lusher00/pov-display/hw/povd-hub/calc/buck_loop.png

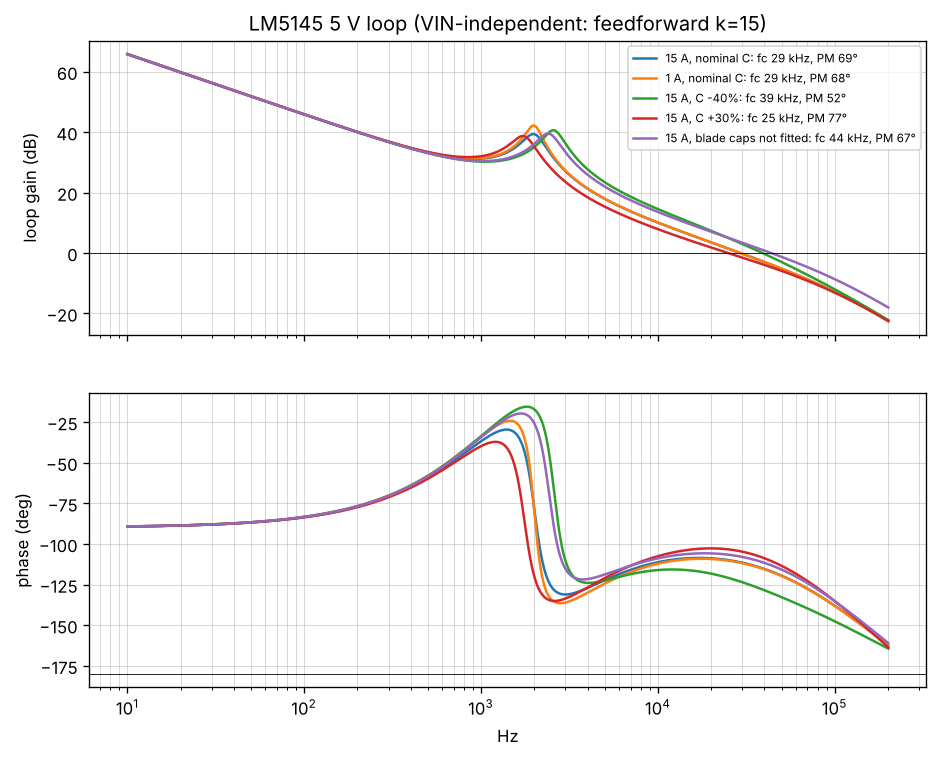
hw/povd-hub/calc/buck_loop.png
