lusher00/pov-display/tools/sim/demo/assets/spinner1.gif

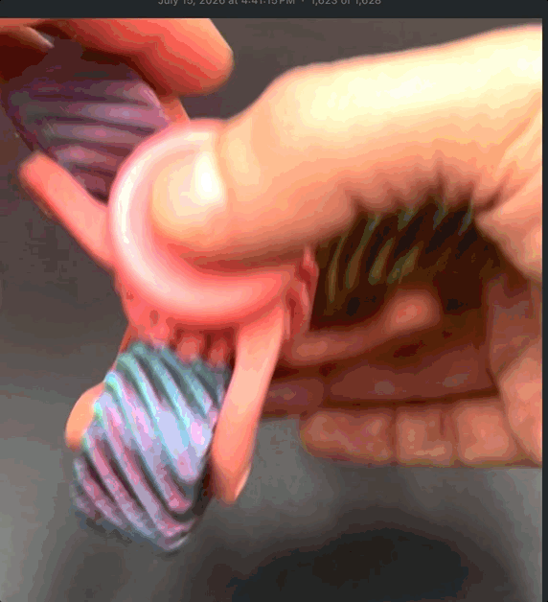
tools/sim/demo/assets/spinner1.gif
