lusher00/pov-display/tools/sim/demo/assets/spinner2.gif

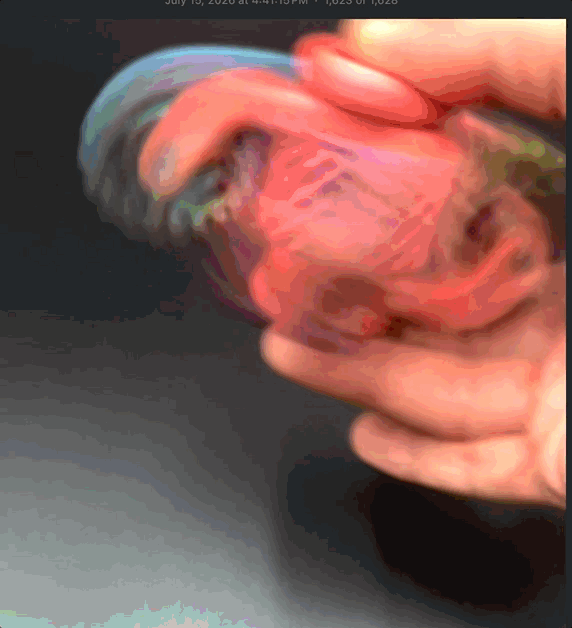
tools/sim/demo/assets/spinner2.gif
