lusher00/pov-display/tools/sim/demo/assets/spinner3.gif

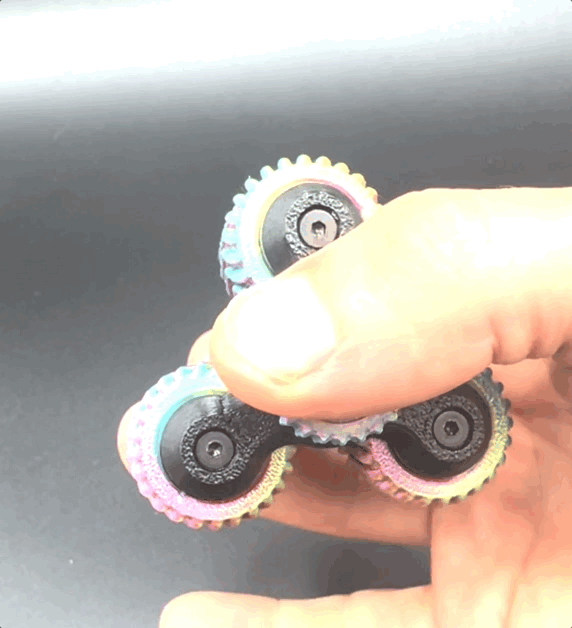
tools/sim/demo/assets/spinner3.gif
