lusher00/pov-display/hw/povd-hub/fab/povd-hub_BOM_JLC.csv

Comment | Designator | Footprint | LCSC Part #
100nF 25V X7R 0603 | C1,C7,C17 | 0603 | C53084467
100nF 50V X7R 0603 | C2,C3,C34,C35,C36,C51,C53,C55 | 0603 | C53084467
10uF 10V X5R 0805 | C9,C33,C39,C40,C41,C42,C45,C46,C47,C48 | 0805 | C15850
1uF 100V X7R 0805 | C10 | 0805 | C105952
47nF 50V X7R 0603 | C15 | 0603 | C1622
2.2uF 16V X7R 0805 | C16 | 0805 | C377773
330pF 100V X7R 0603 (Yageo CC0603KRX7R0BB331) | C19 | 0603 | C576850
6.8nF 50V X7R 0603 | C20 | 0603 | C1631
12nF 50V X7R 0603 | C21 | 0603 | C107074
68pF 50V C0G 0603 | C22 | 0603 | C28262
1uF 16V X7R 0603 | C49 | 0603 | C15849
1nF 50V X7R 0603 | C50,C52 | 0603 | C1588
B5819W | D2 | SOD-123 | C8598
Green LED 0603 | D3 | 0603 | C12065
PESD5V0S1BA | D4,D5,D6 | SOD-323 | C19224
GH 4P | J4,J6 | JST GH BM04B-GHS-TBT | C161692
GH 5P OPT | J5 | JST GH BM05B-GHS-TBT | C189891
BSC040N08NS5 | Q1,Q3 | TDSON-8 (PG-TDSON-8) | C534333
CSD19533Q5A | Q2 | SON 5x6 (TDSON-8 land) | C110197
AO3400A | Q4 | SOT-23 | C20917
1k 1% 0603 | R2,R37,R39,R43 | 0603 | C21190
95.3k 1% 0603 | R5 | 0603 | C23267
16.9k 1% 0603 | R6 | 0603 | C227614
10k 1% 0603 | R7,R13,R17 | 0603 | C25804
100k 1% 0603 | R8,R42 | 0603 | C25803
24.9k 1% 0603 | R9 | 0603 | C25962
2.2R 1% 0603 | R10 | 0603 | C22939
360R 1% 0603 | R11 | 0603 | C25194
2.2R 0.5W 0805 anti-surge (Panasonic ERJ-P06J2R2V) | R12 | 0805 | C543414
1.91k 1% 0603 | R14 | 0603 | C22853
680R 1% 0603 | R15 | 0603 | C23228
11k 1% 0603 | R16 | 0603 | C25950
2.2k 1% 0603 | R18 | 0603 | C4190
33R 1% 0603 | R20,R21,R22,R23,R24,R25,R26,R27,R28,R29,R30,R31,R32,R33,R34,R35 | 0603 | C23140
4.7k 1% 0603 | R36,R38 | 0603 | C23162
47R 1% 1206 | R40 | 1206 | C17969
100R 1% 0603 | R41,R44 | 0603 | C22775
Keystone 5015 test point | TP7,TP8,TP10,TP11,TP12,TP13,TP14,TP15,TP16,TP17 | Keystone 5015 | C2906768
LM74700-Q1 | U1 | SOT-23-6 | C2941042
INA240A3D | U2 | SOIC-8 | C2060584
LMR51610XDBVR | U3 | SOT-23-6 | C20539658
LM5145QRGYRQ1 | U4 | VQFN-20 3.5x4.5 (RGY) | C3188678
74AHCT245PW | U6,U7 | TSSOP-20 | C173388
74LVC1G17 | U8,U9,U10 | SOT-23-5 | C7836
