lusher00/pov-display/hw/povd-hub/povd-hub-schematic.pdf

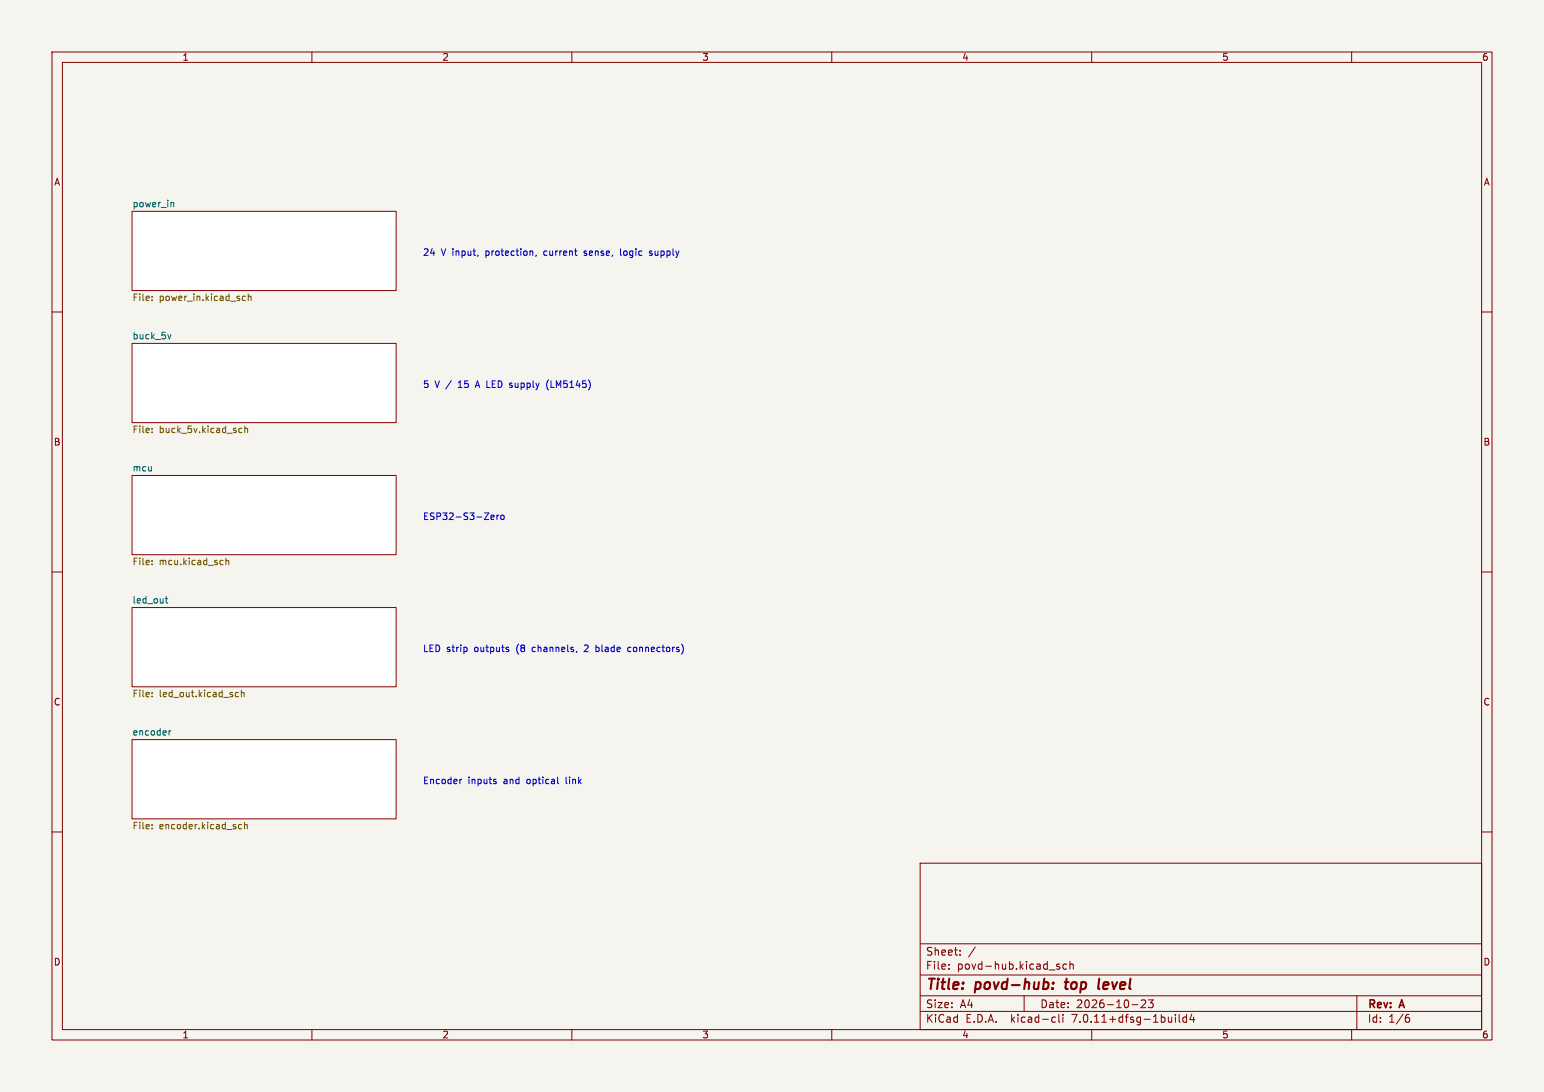
[picture p7: page 1]

buck_5v File: buck_5v.kicad_sch mcu File: mcu.kicad_sch

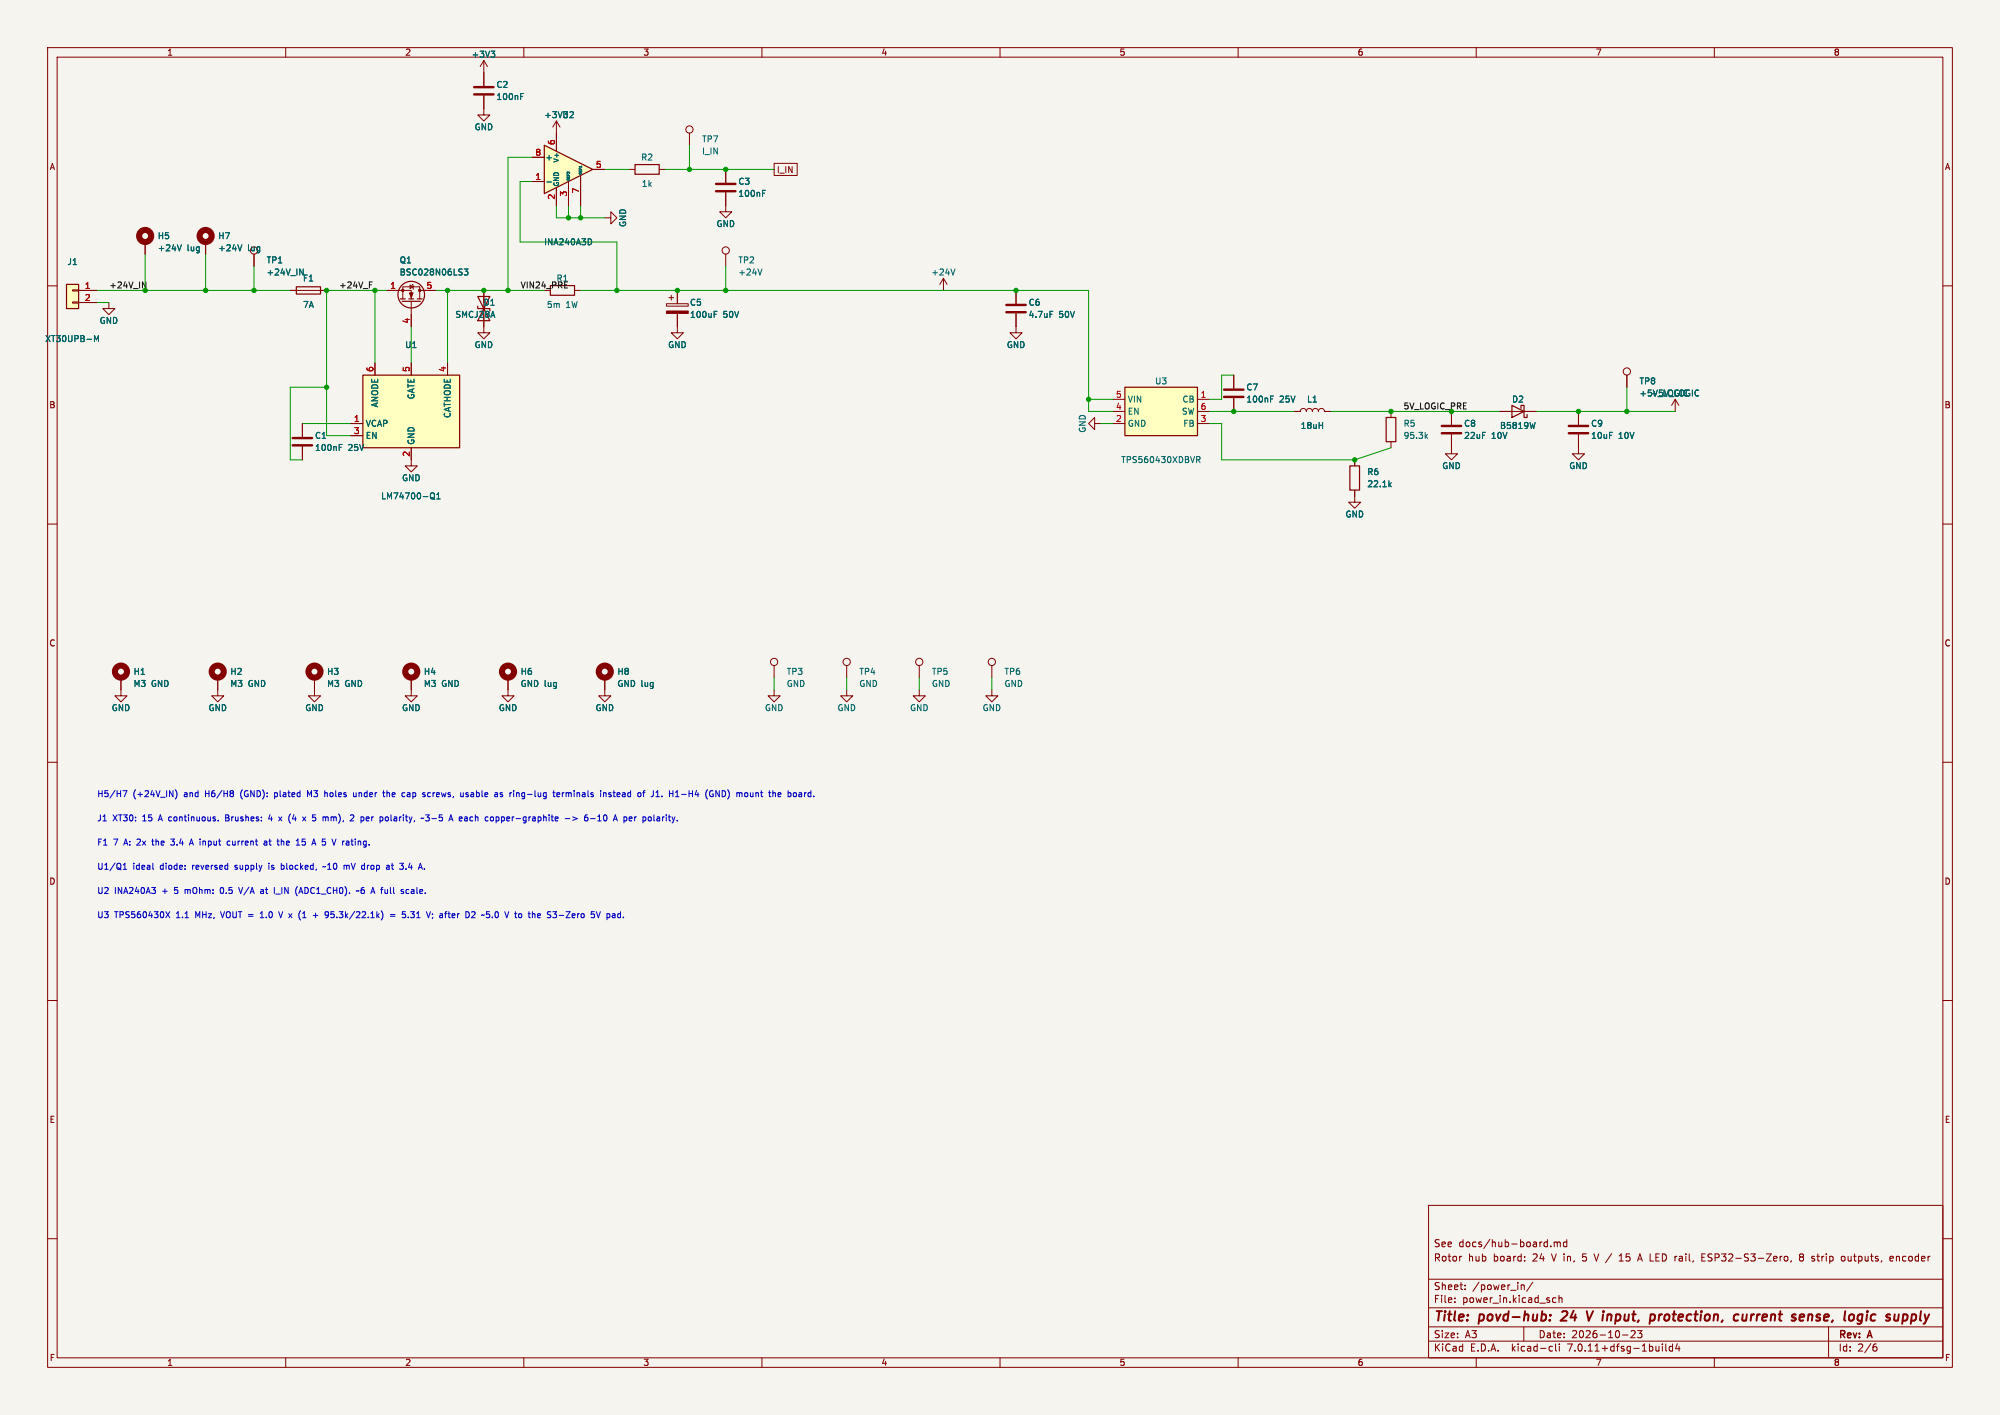
[picture p8: page 2]

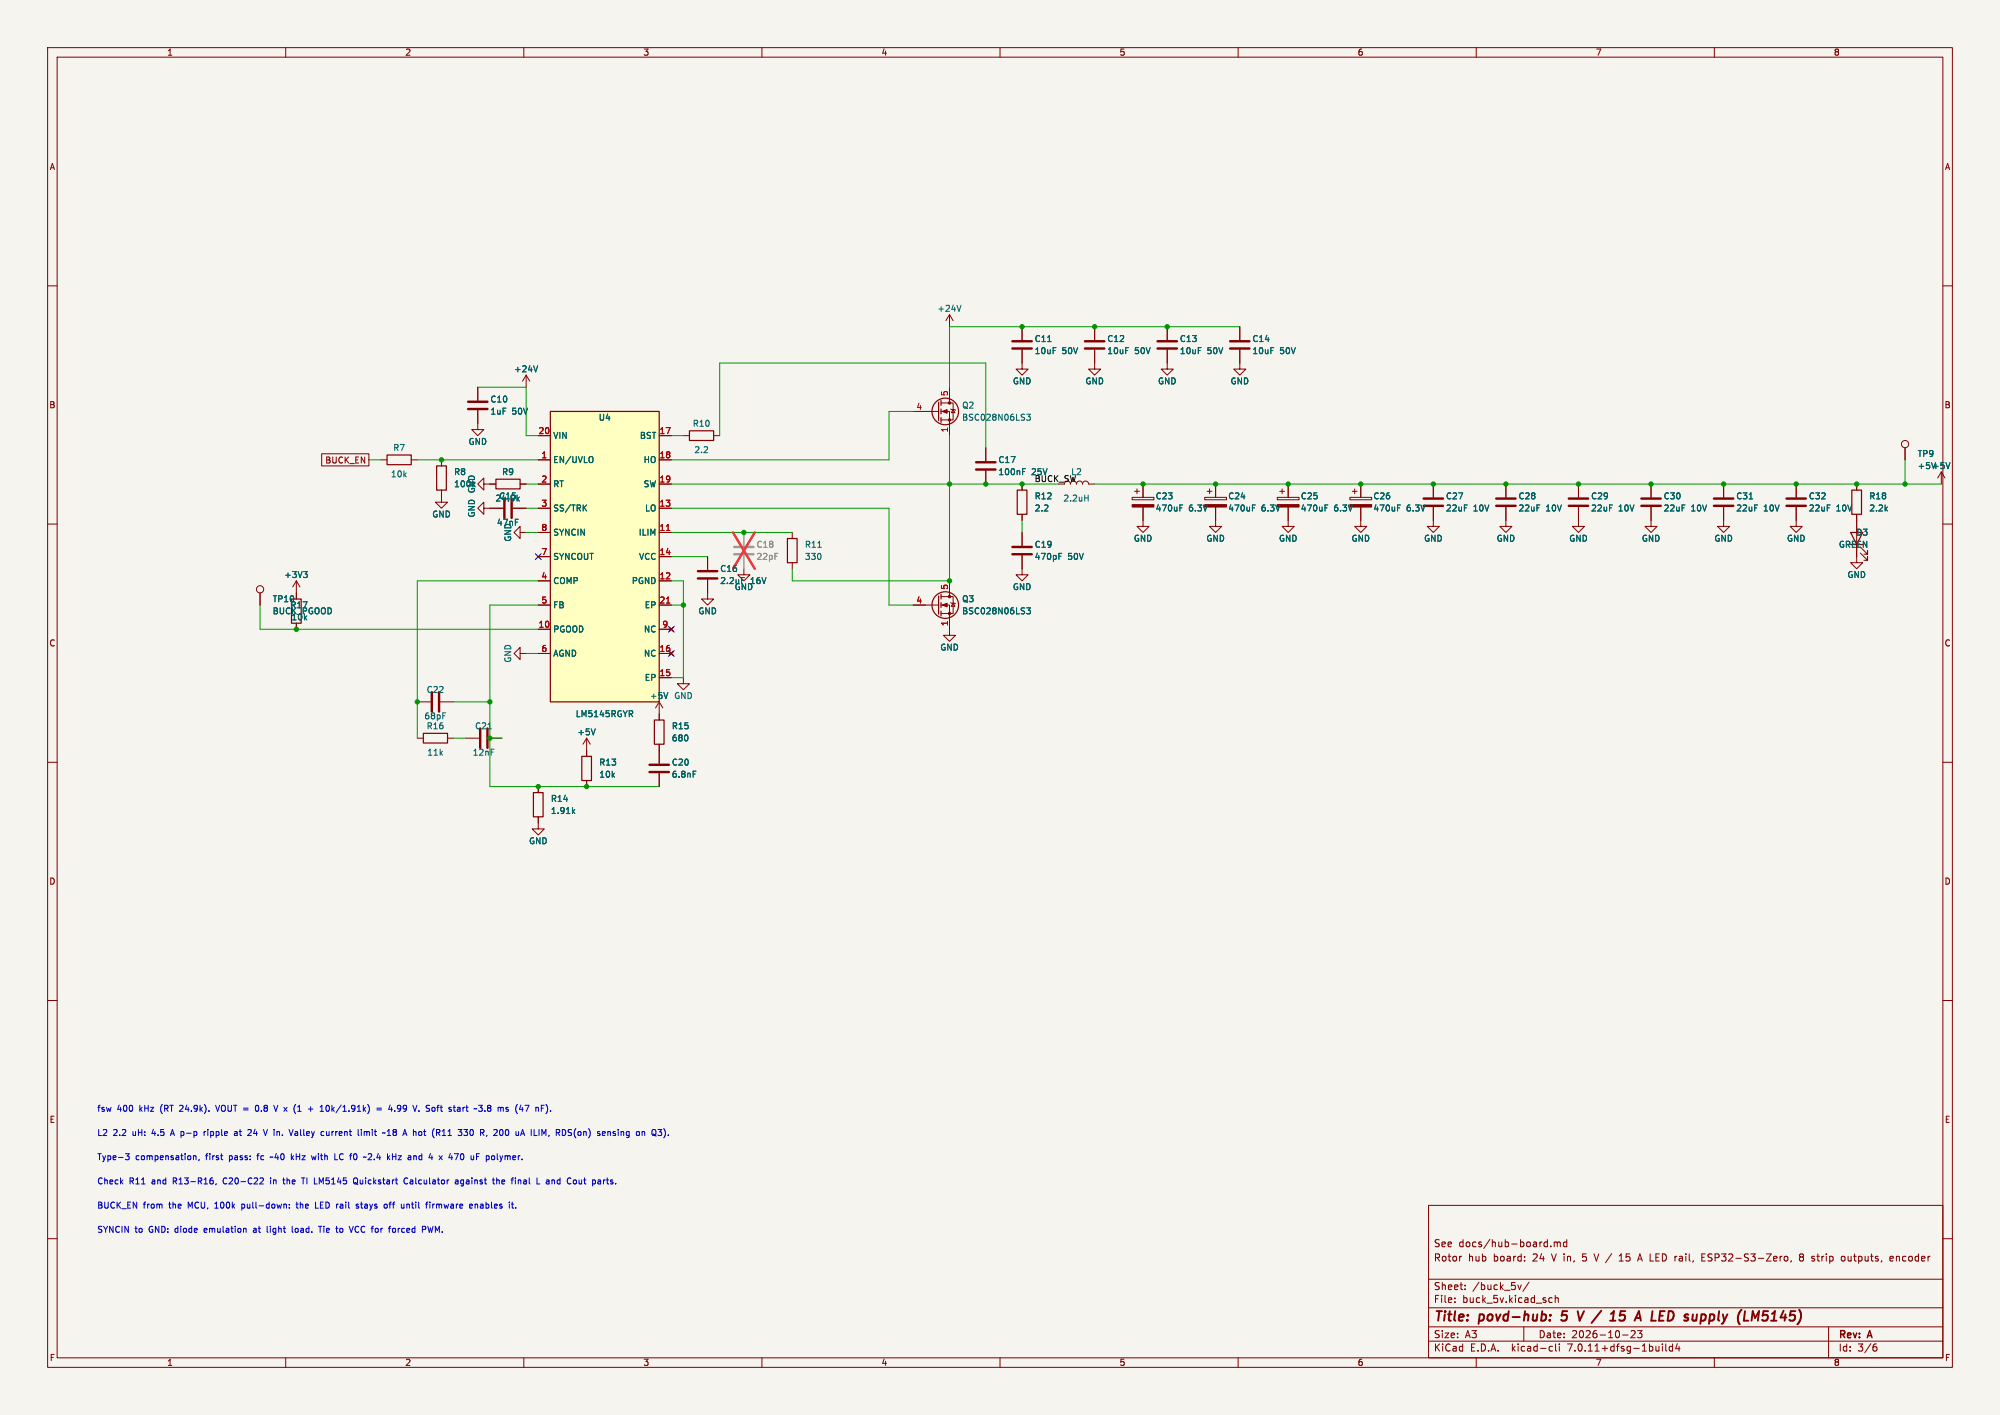
[picture p9: page 3]

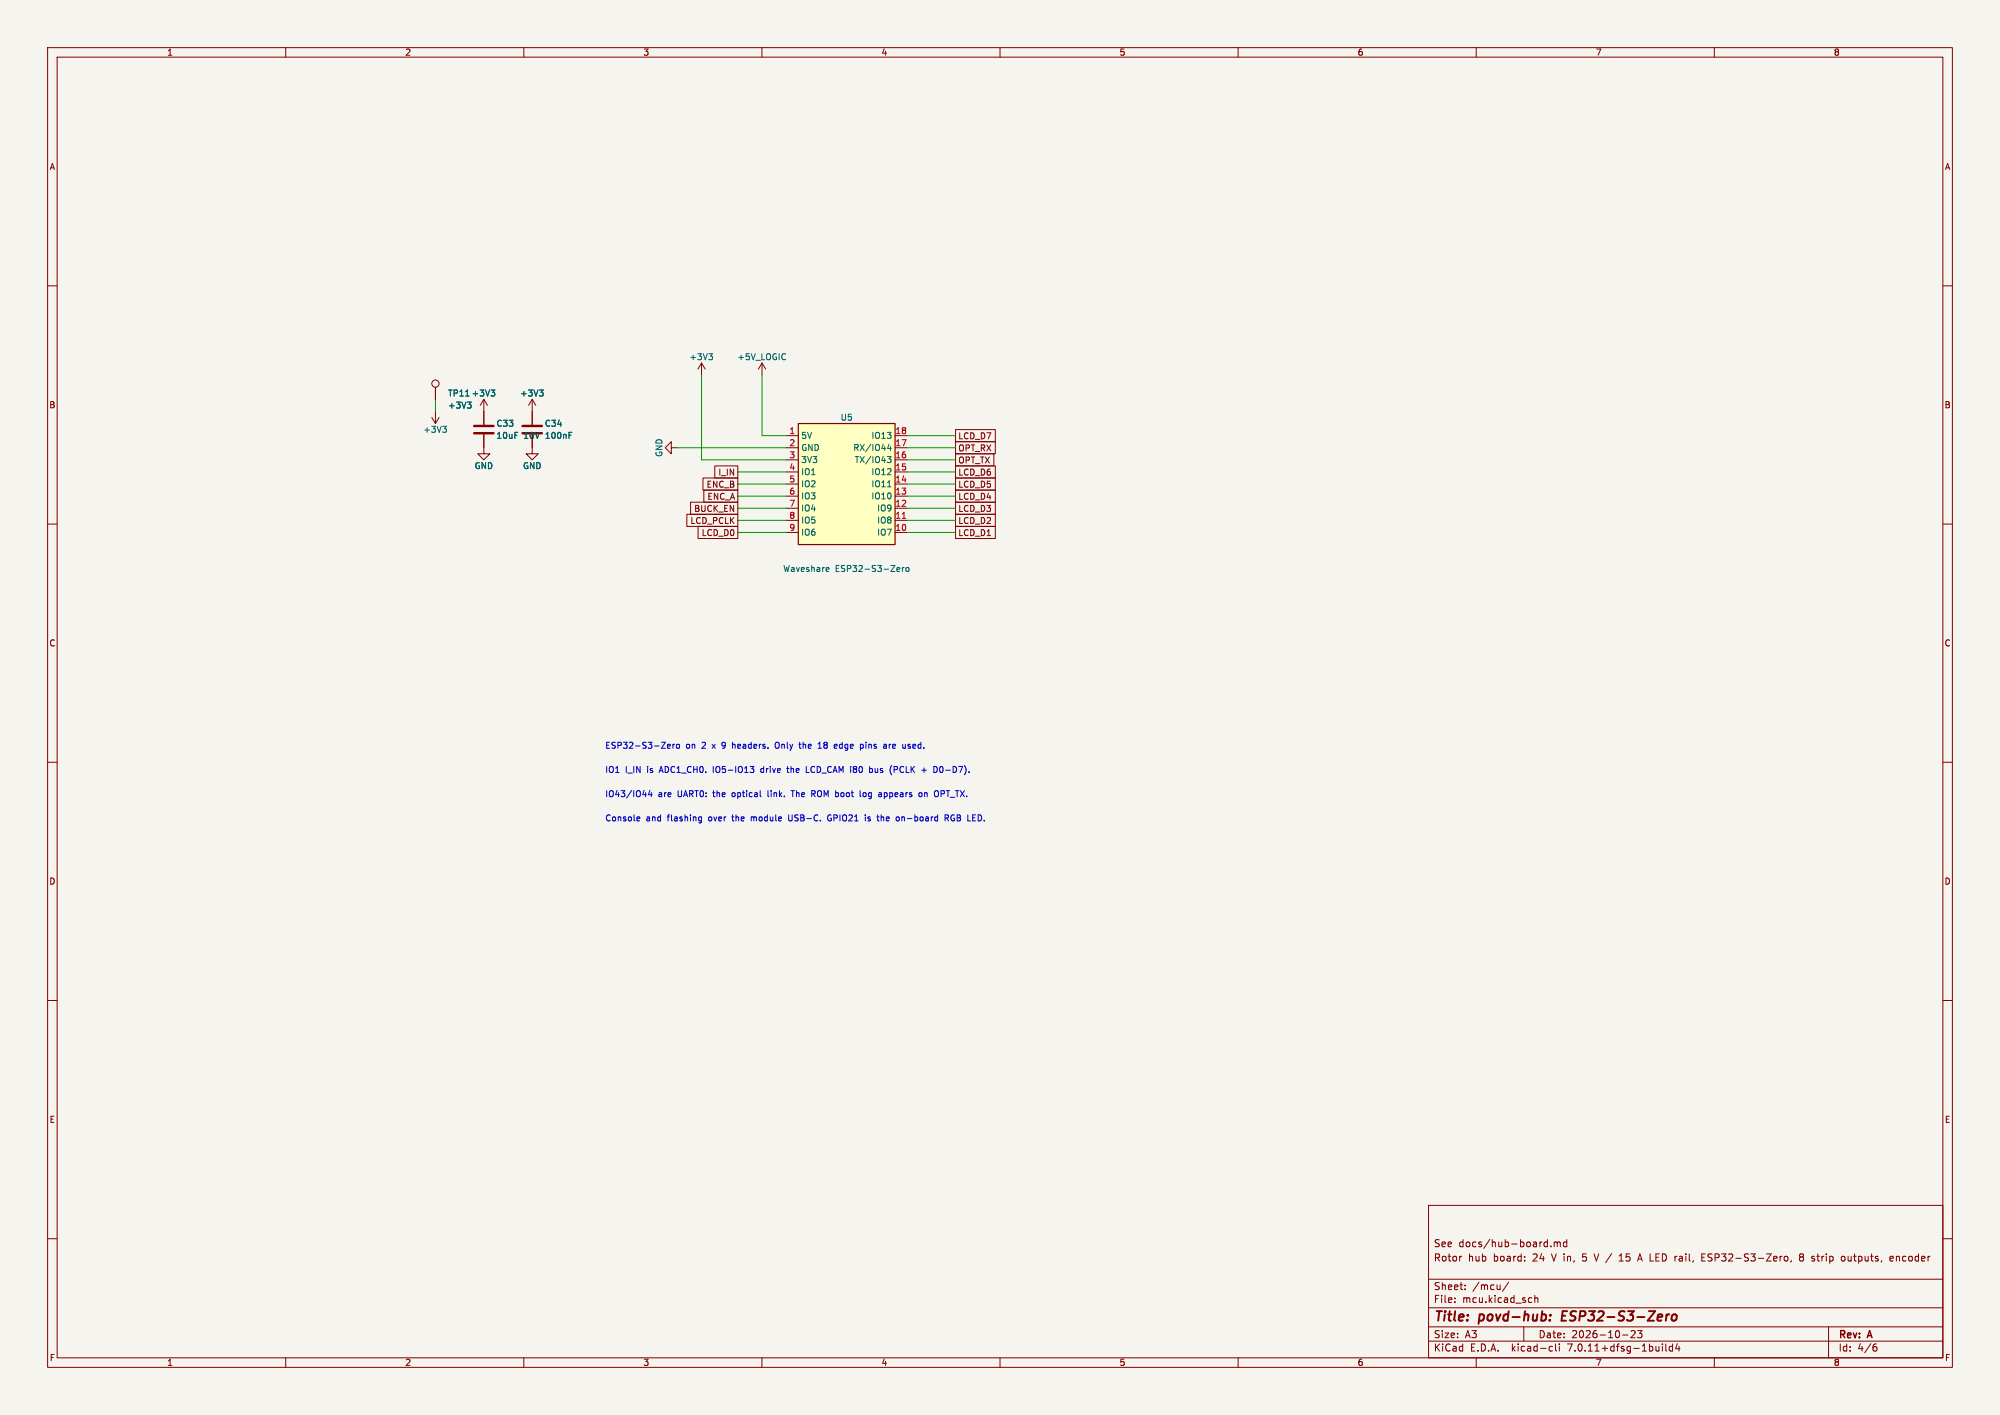
[picture p10: page 4]

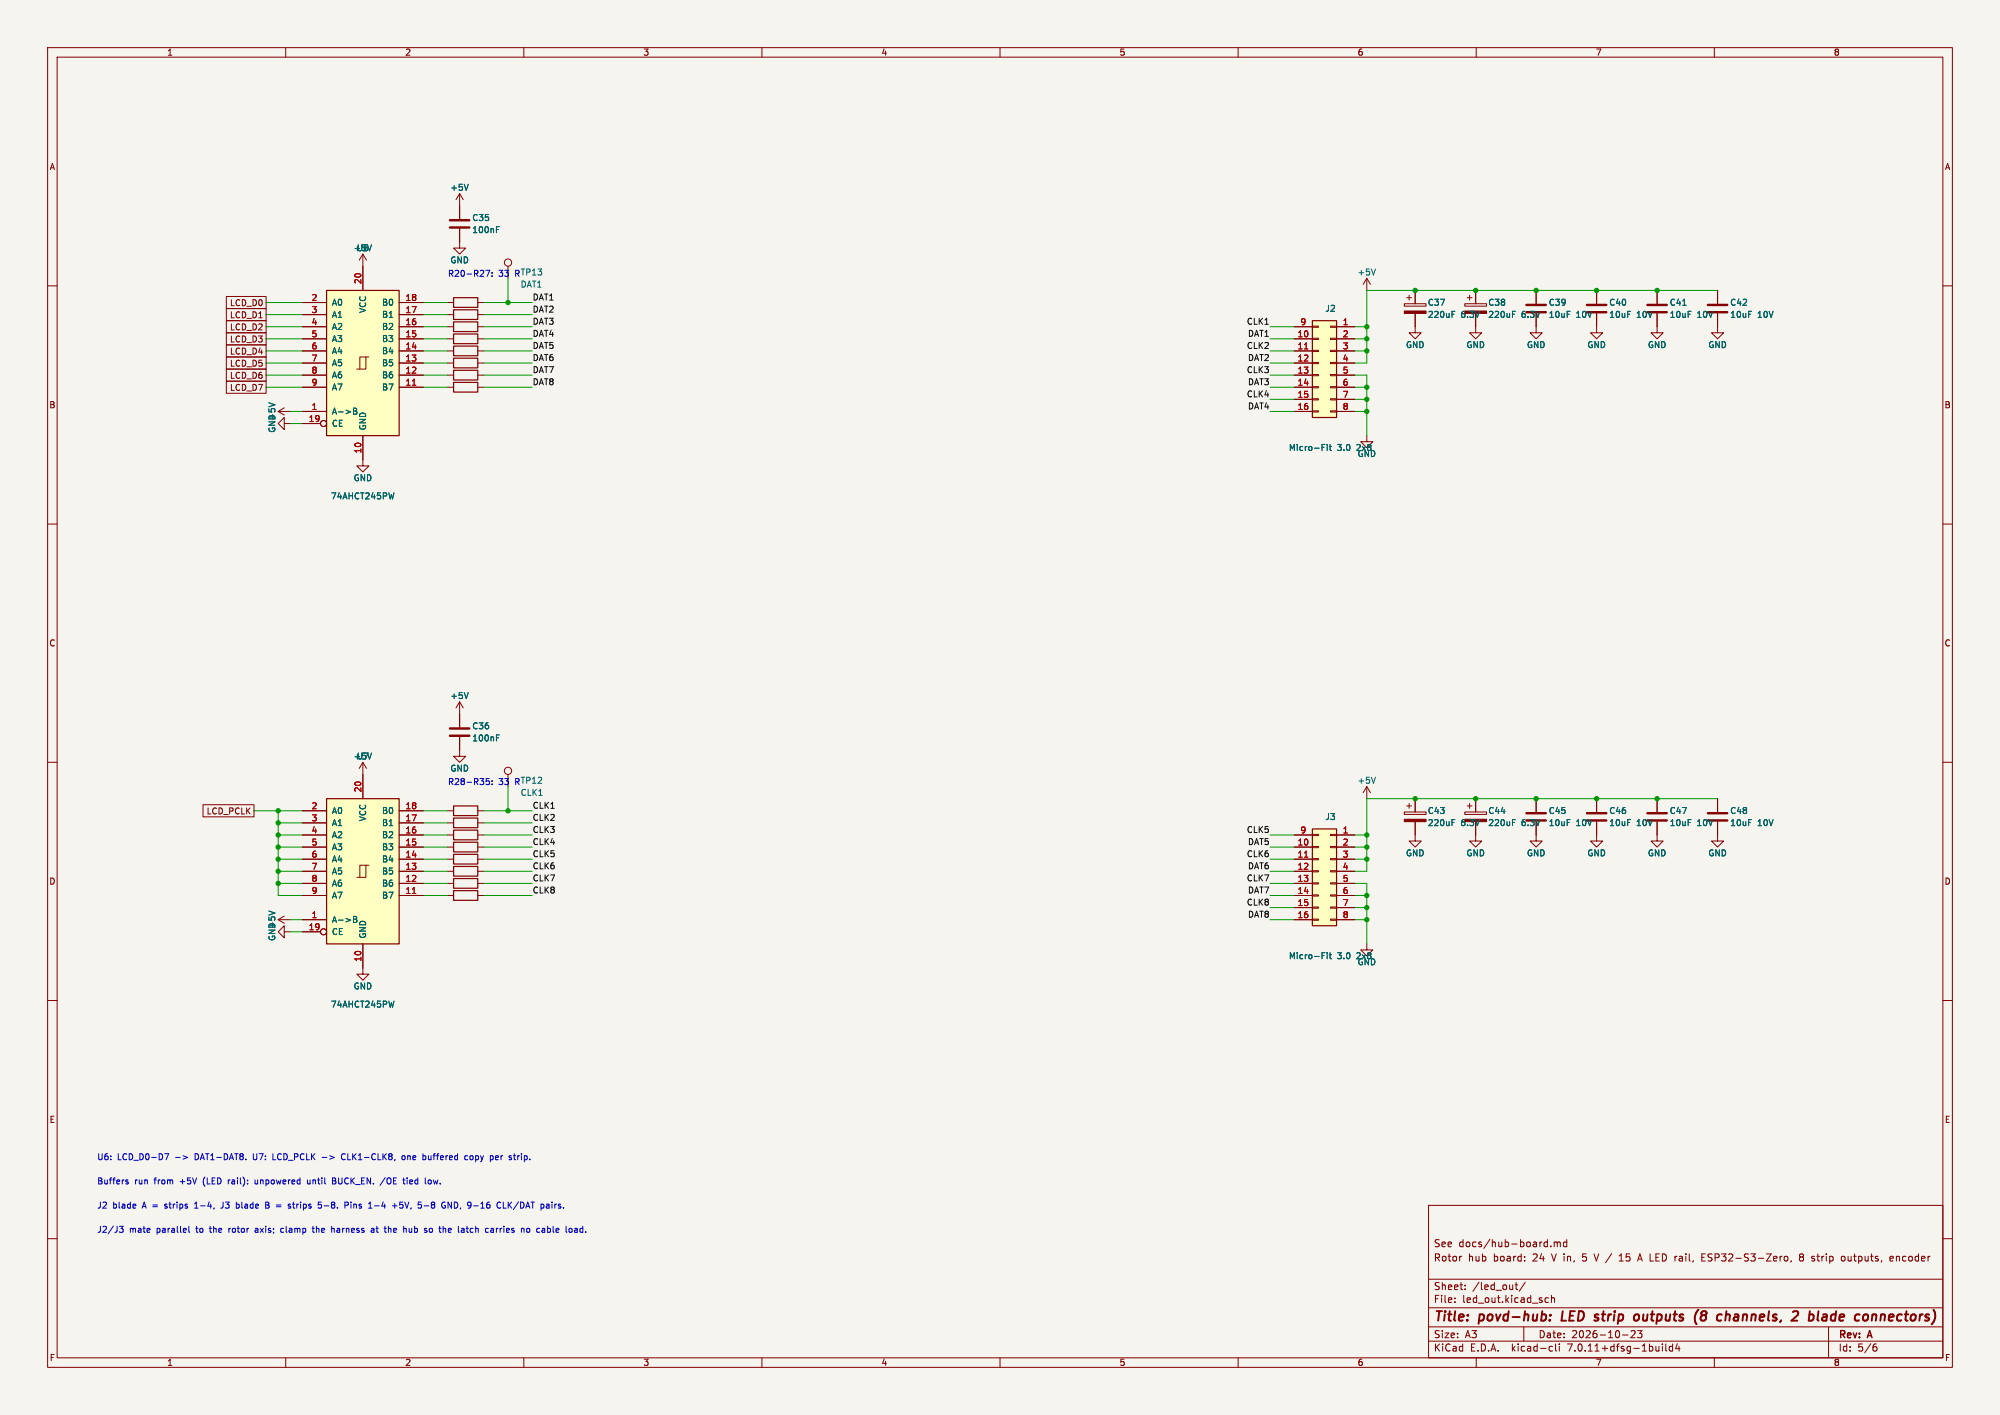
[picture p11: page 5]

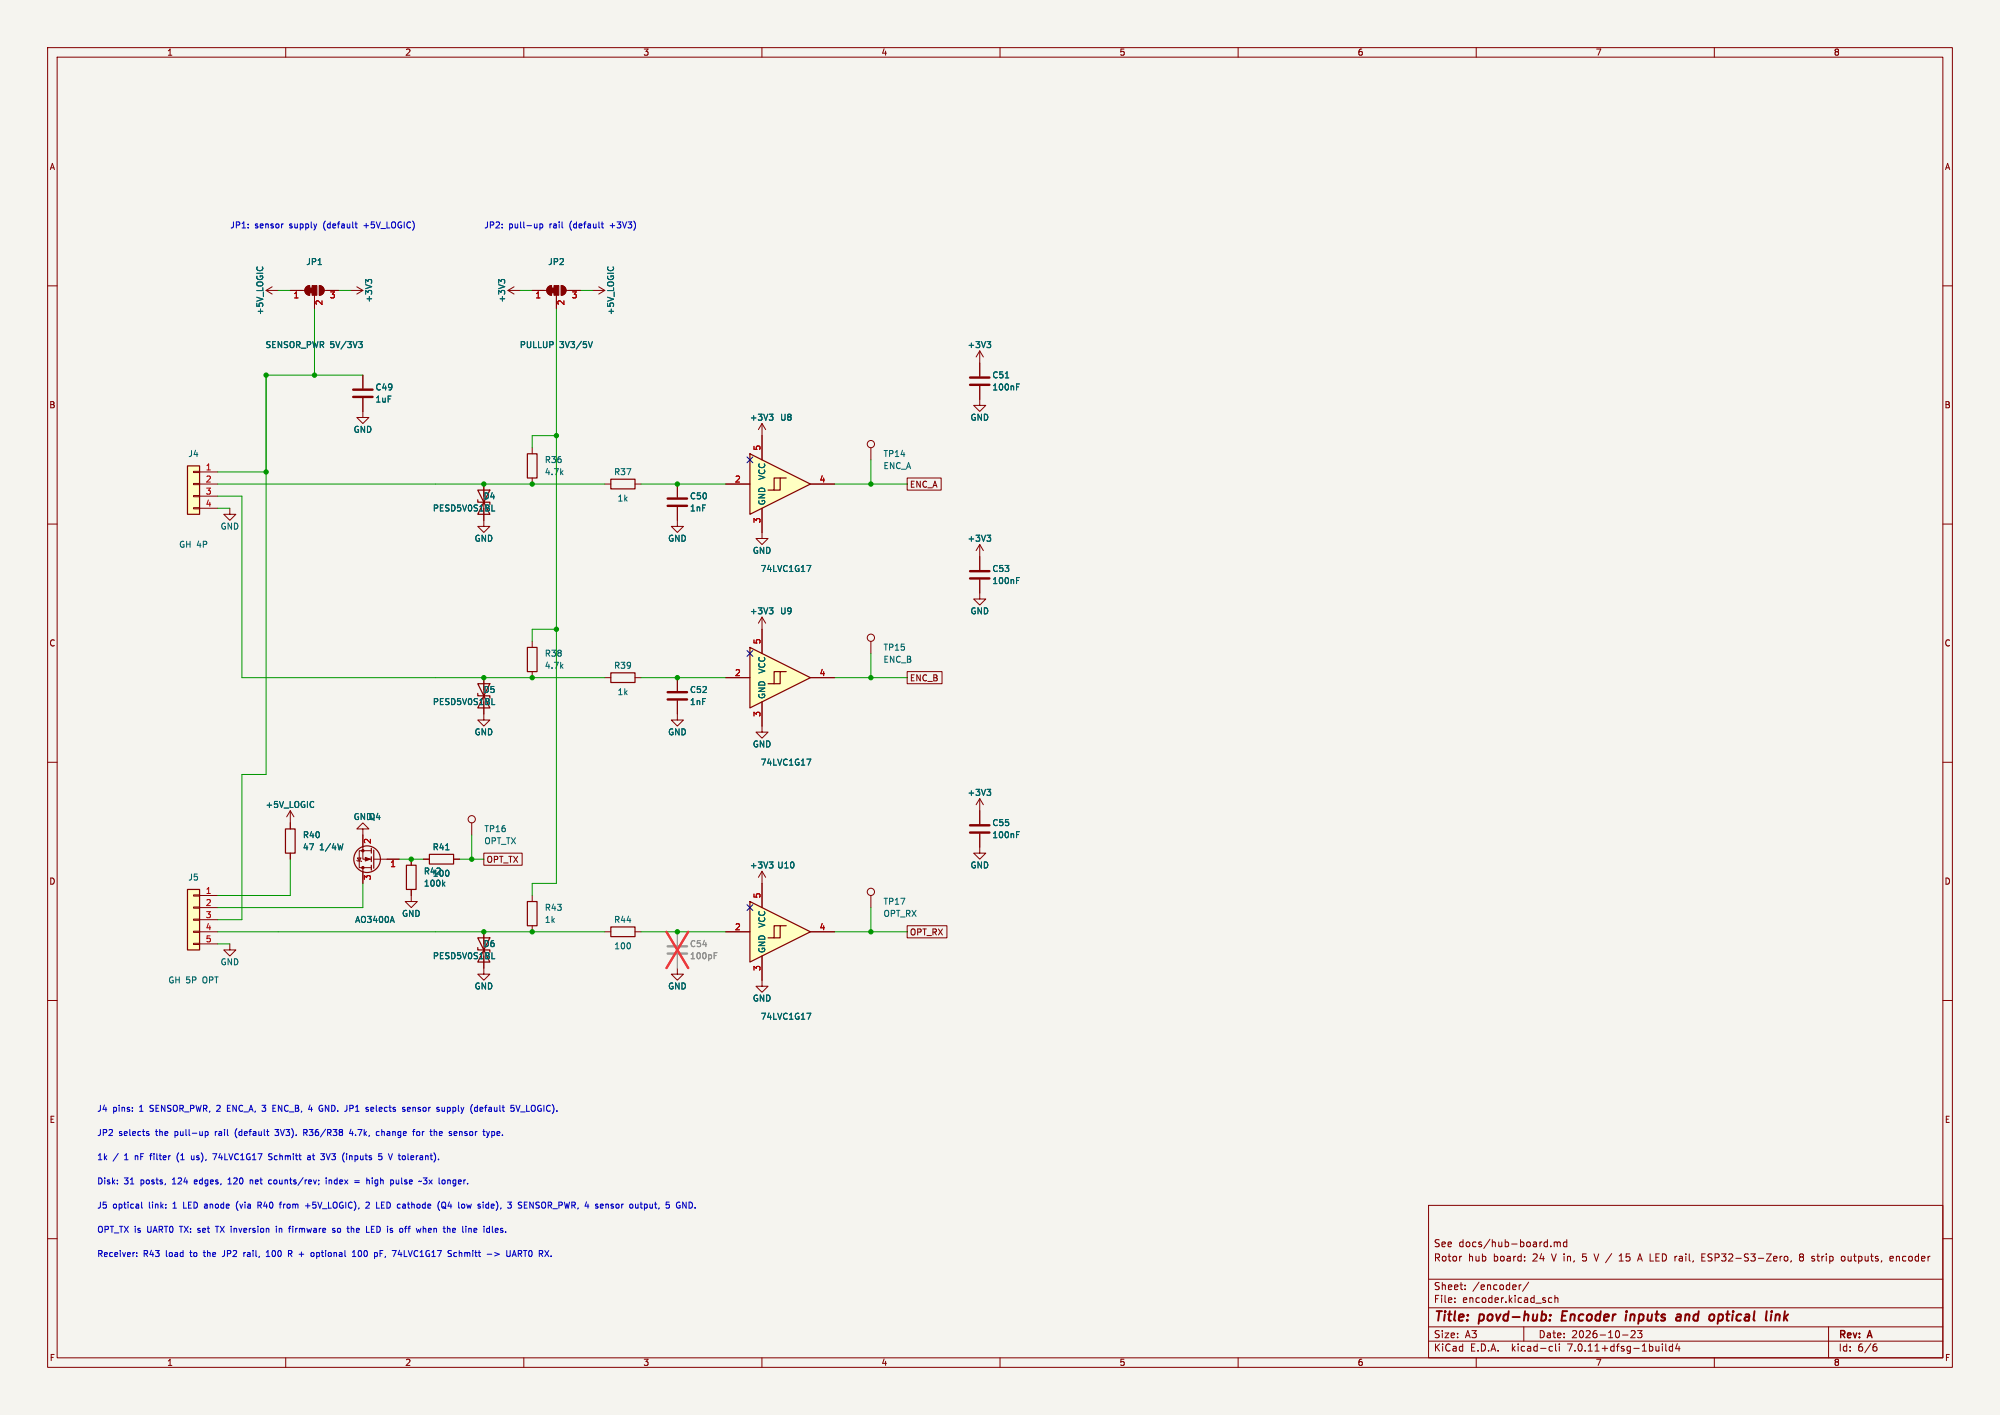
[picture p12: page 6]
