lusher00/pov-display/(list of files, drawings)

Other design files:
hw/povd-hub/povd-hub.dsn
