lusher00/pov-display/hw/povd-hub/povd-hub.kicad_pcb

## KiCad design hw/povd-hub/povd-hub.kicad_pcb (2026-10-29)

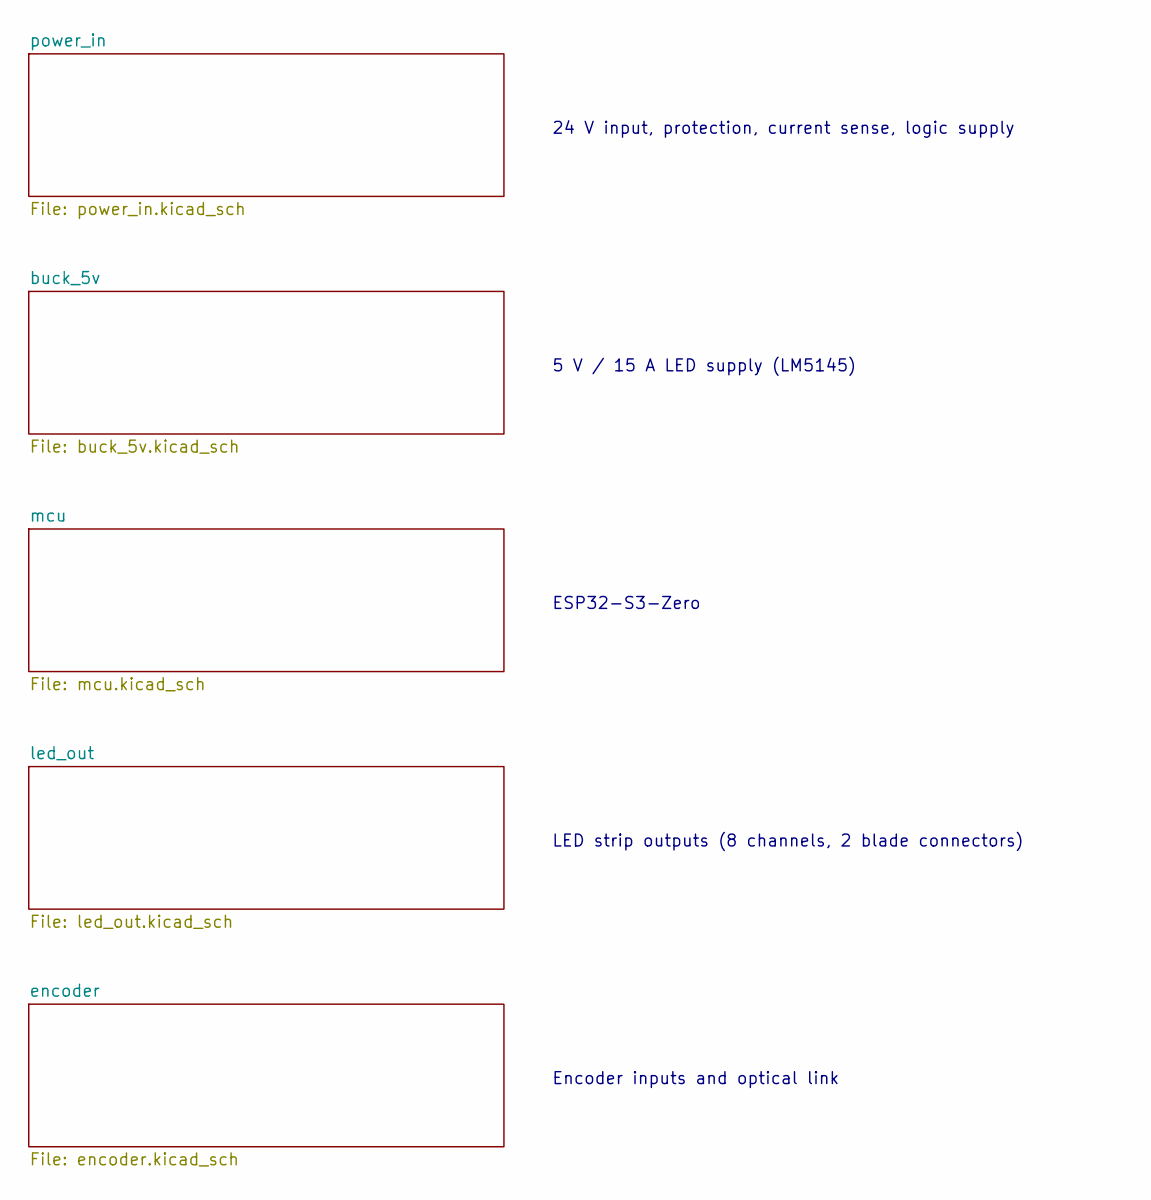
[picture p13: schematic povd-hub.kicad_sch, povd-hub: top level]

Notes on the sheet:
LED strip outputs (8 channels, 2 blade connectors)
Encoder inputs and optical link
ESP32-S3-Zero
24 V input, protection, current sense, logic supply
5 V / 15 A LED supply (LM5145)

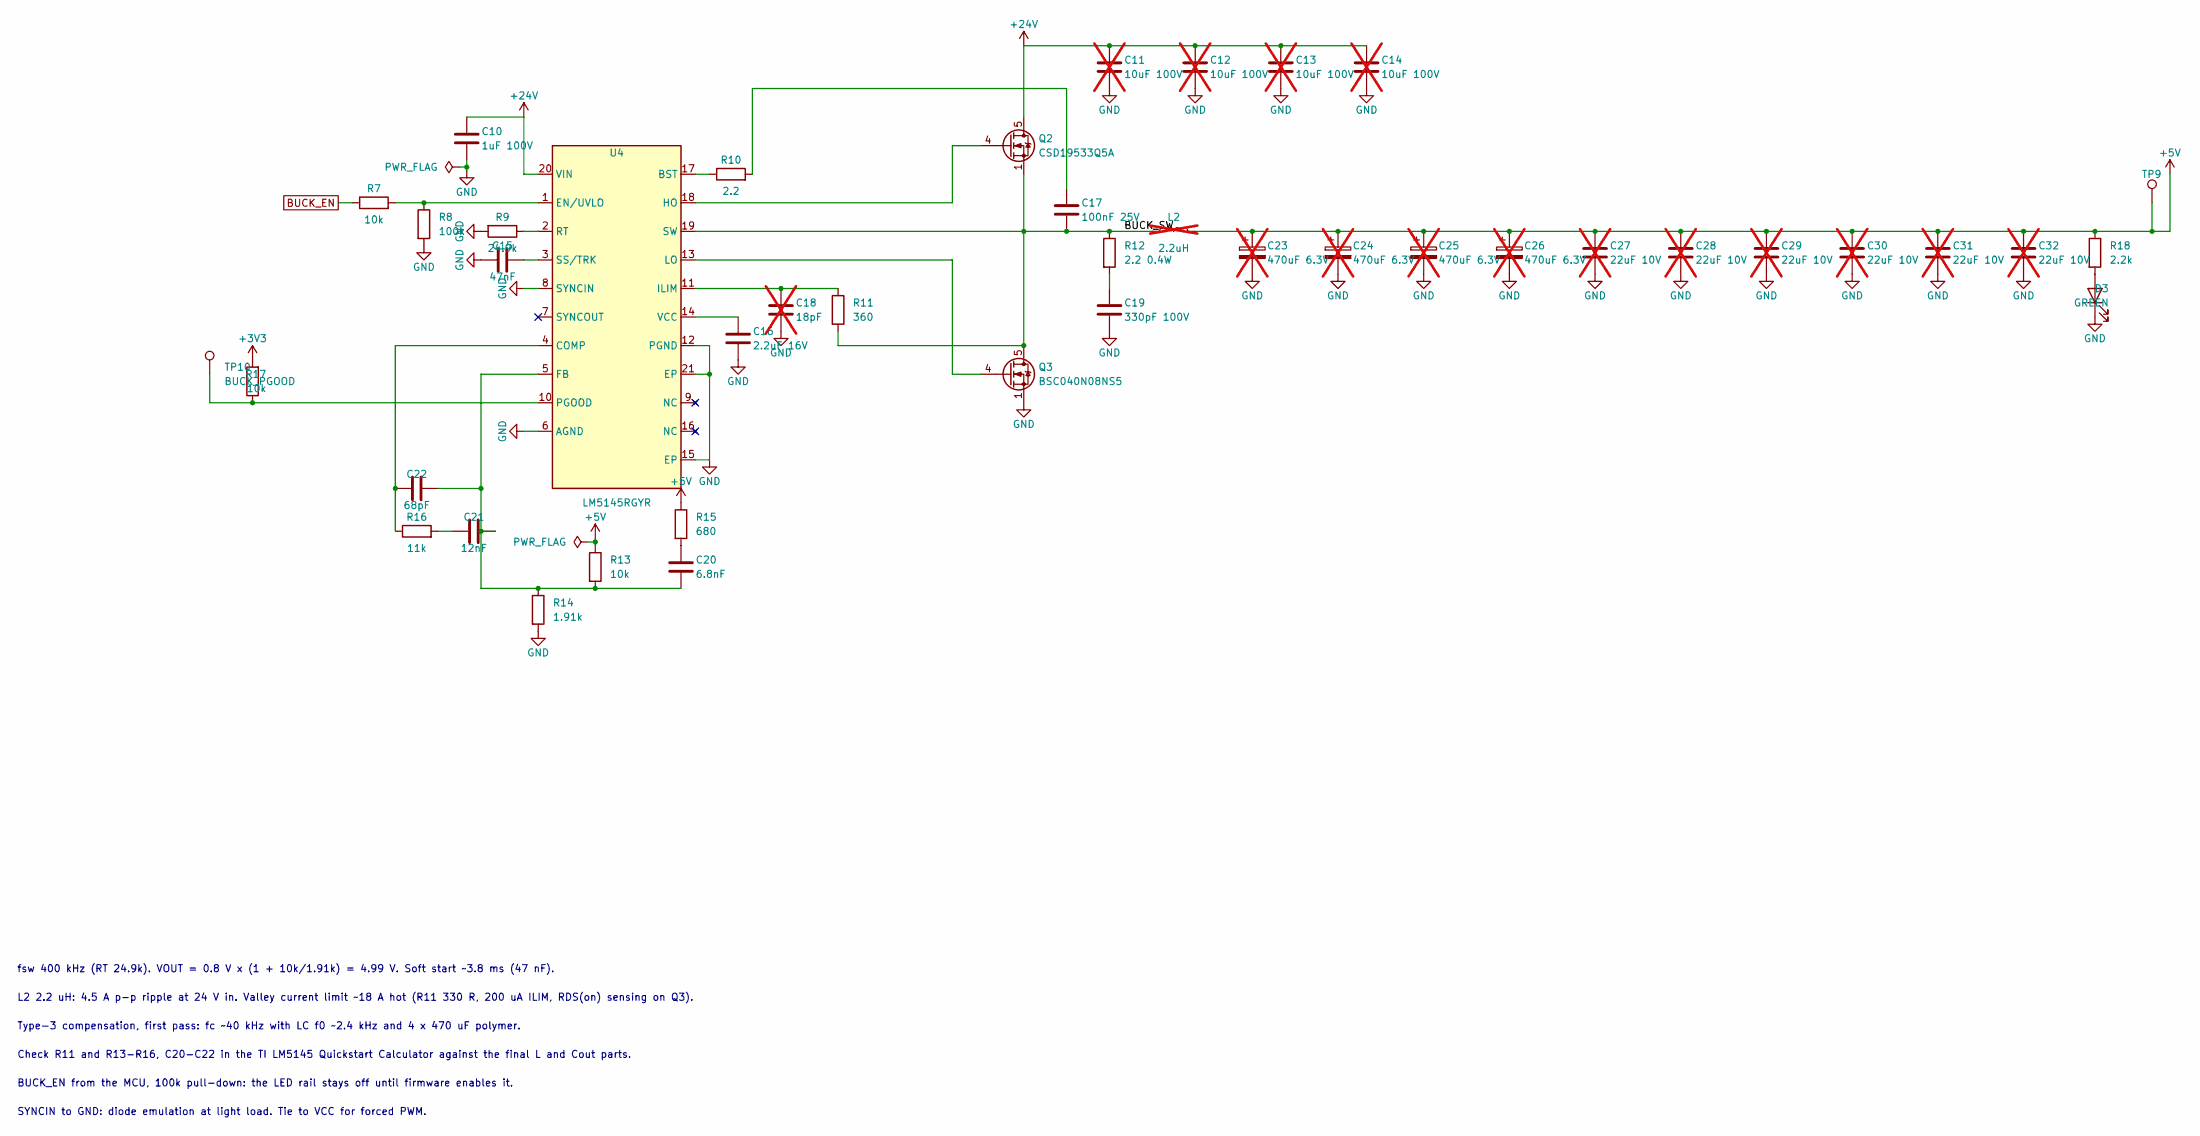
[picture p14: schematic buck_5v.kicad_sch, povd-hub: 5 V / 15 A LED supply (LM5145)]

Parts:
C10: 1uF 100V; C_0805_2012Metric
C11, C12, C13, C14: 10uF 100V; C_1210_3225Metric; not fitted
C15: 47nF; C_0603_1608Metric
C16: 2.2uF 16V; C_0805_2012Metric
C17: 100nF 25V; C_0603_1608Metric; LCSC C53084467
C18: 18pF; C_0603_1608Metric; not fitted
C19: 330pF 100V; C_0603_1608Metric; LCSC C576850
C20: 6.8nF; C_0603_1608Metric
C21: 12nF; C_0603_1608Metric
C22: 68pF; C_0603_1608Metric
C23: 470uF 6.3V; CP_EIA-7343-31_Kemet-D; MPN KEMET T520D477M006ATE010 or equiv polym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; not fitted
C24, C25, C26: 470uF 6.3V; CP_EIA-7343-31_Kemet-D; not fitted
C27, C28, C29, C30, C31, C32: 22uF 10V; C_1210_3225Metric; not fitted
D3: GREEN; LED_0603_1608Metric
L2: 2.2uH; L_Wuerth_HCI-1365; MPN 2.2 uH, Isat >= 20 A, 13 mm molded (Wur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; not fitted
Q2: CSD19533Q5A; TDSON-8-1; MPN TI CSD19533Q5A (100 V, 9.5 mOhm, 27 nC); LCSC C110197
Q3: BSC040N08NS5; TDSON-8-1; MPN Infineon BSC040N08NS5 (80 V, 4.0 mOhm, 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; LCSC C534333
R7, R13, R17: 10k; R_0603_1608Metric; LCSC C25804
R8: 100k; R_0603_1608Metric
R9: 24.9k; R_0603_1608Metric
R10: 2.2; R_0603_1608Metric
R11: 360; R_0603_1608Metric; LCSC C25194
R12: 2.2 0.4W; R_0805_2012Metric; LCSC C543414
R14: 1.91k; R_0603_1608Metric
R15: 680; R_0603_1608Metric
R16: 11k; R_0603_1608Metric
R18: 2.2k; R_0603_1608Metric
TP9: +5V; TestPoint_Keystone_5010-5014_Multipurpose; MPN Keystone 5011
TP10: BUCK_PGOOD; TestPoint_Keystone_5015_Micro-Minature; MPN Keystone 5015; LCSC C2906768
U4: LM5145RGYR; Texas_RGY_R-PVQFN-N20_EP2.05x3.05mm; MPN TI LM5145RGYR (LCSC C485912); LCSC C485912

Connections:
+3V3: R17.2; also elsewhere on the board
+5V: C23.1, C24.1, C25.1, C26.1, C27.1, C28.1, C29.1, C30.1, C31.1, C32.1, L2.2, R13.1, R15.1, R18.1, TP9.1 (1_1); also elsewhere on the board
+24V: C10.1, C11.1, C12.1, C13.1, C14.1, Q2.5 (D), U4.20 (VIN); also elsewhere on the board
/buck_5v/BUCK_SW: C17.2, L2.1, Q2.1 (S), Q2.2 (S), Q2.3 (S), Q3.5 (D), R11.2, R12.1, U4.19 (SW)
BUCK_EN: R7.1; also elsewhere on the board
GND: C10.2, C11.2, C12.2, C13.2, C14.2, C15.2, C16.2, C18.2, C19.2, C23.2, C24.2, C25.2, C26.2, C27.2, C28.2, C29.2, C30.2, C31.2, C32.2, D3.1 (K), Q3.1 (S), Q3.2 (S), Q3.3 (S), R8.2, R9.2, R14.2, U4.6 (AGND), U4.8 (SYNCIN), U4.12 (PGND), U4.15 (EP), U4.21 (EP); also elsewhere on the board
unnamed: C17.1, R10.2
unnamed: C19.1, R12.2
unnamed: C20.1, R15.2
unnamed: C21.1, R16.2
unnamed: D3.2 (A), R18.2
unnamed: Q2.4 (G), U4.18 (HO)
unnamed: Q3.4 (G), U4.13 (LO)
unnamed: R10.1, U4.17 (BST)
unnamed: C22.1, R16.1, U4.4 (COMP)
unnamed: R7.2, R8.1, U4.1 (EN/UVLO)
unnamed: C20.2, C21.2, C22.2, R13.2, R14.1, U4.5 (FB)
unnamed: C18.1, R11.1, U4.11 (ILIM)
unnamed: R17.1, TP10.1 (1_1), U4.10 (PGOOD)
unnamed: R9.1, U4.2 (RT)
unnamed: C15.1, U4.3 (SS/TRK)
unnamed: C16.1, U4.14 (VCC)

Notes on the sheet:
L2 2.2 uH: 4.5 A p-p ripple at 24 V in. Valley current limit ~18 A hot (R11 330 R, 200 uA ILIM, RDS(on) sensing on Q3).
Check R11 and R13-R16, C20-C22 in the TI LM5145 Quickstart Calculator against the final L and Cout parts.
SYNCIN to GND: diode emulation at light load. Tie to VCC for forced PWM.
fsw 400 kHz (RT 24.9k). VOUT = 0.8 V x (1 + 10k/1.91k) = 4.99 V. Soft start ~3.8 ms (47 nF).
Type-3 compensation, first pass: fc ~40 kHz with LC f0 ~2.4 kHz and 4 x 470 uF polymer.
BUCK_EN from the MCU, 100k pull-down: the LED rail stays off until firmware enables it.

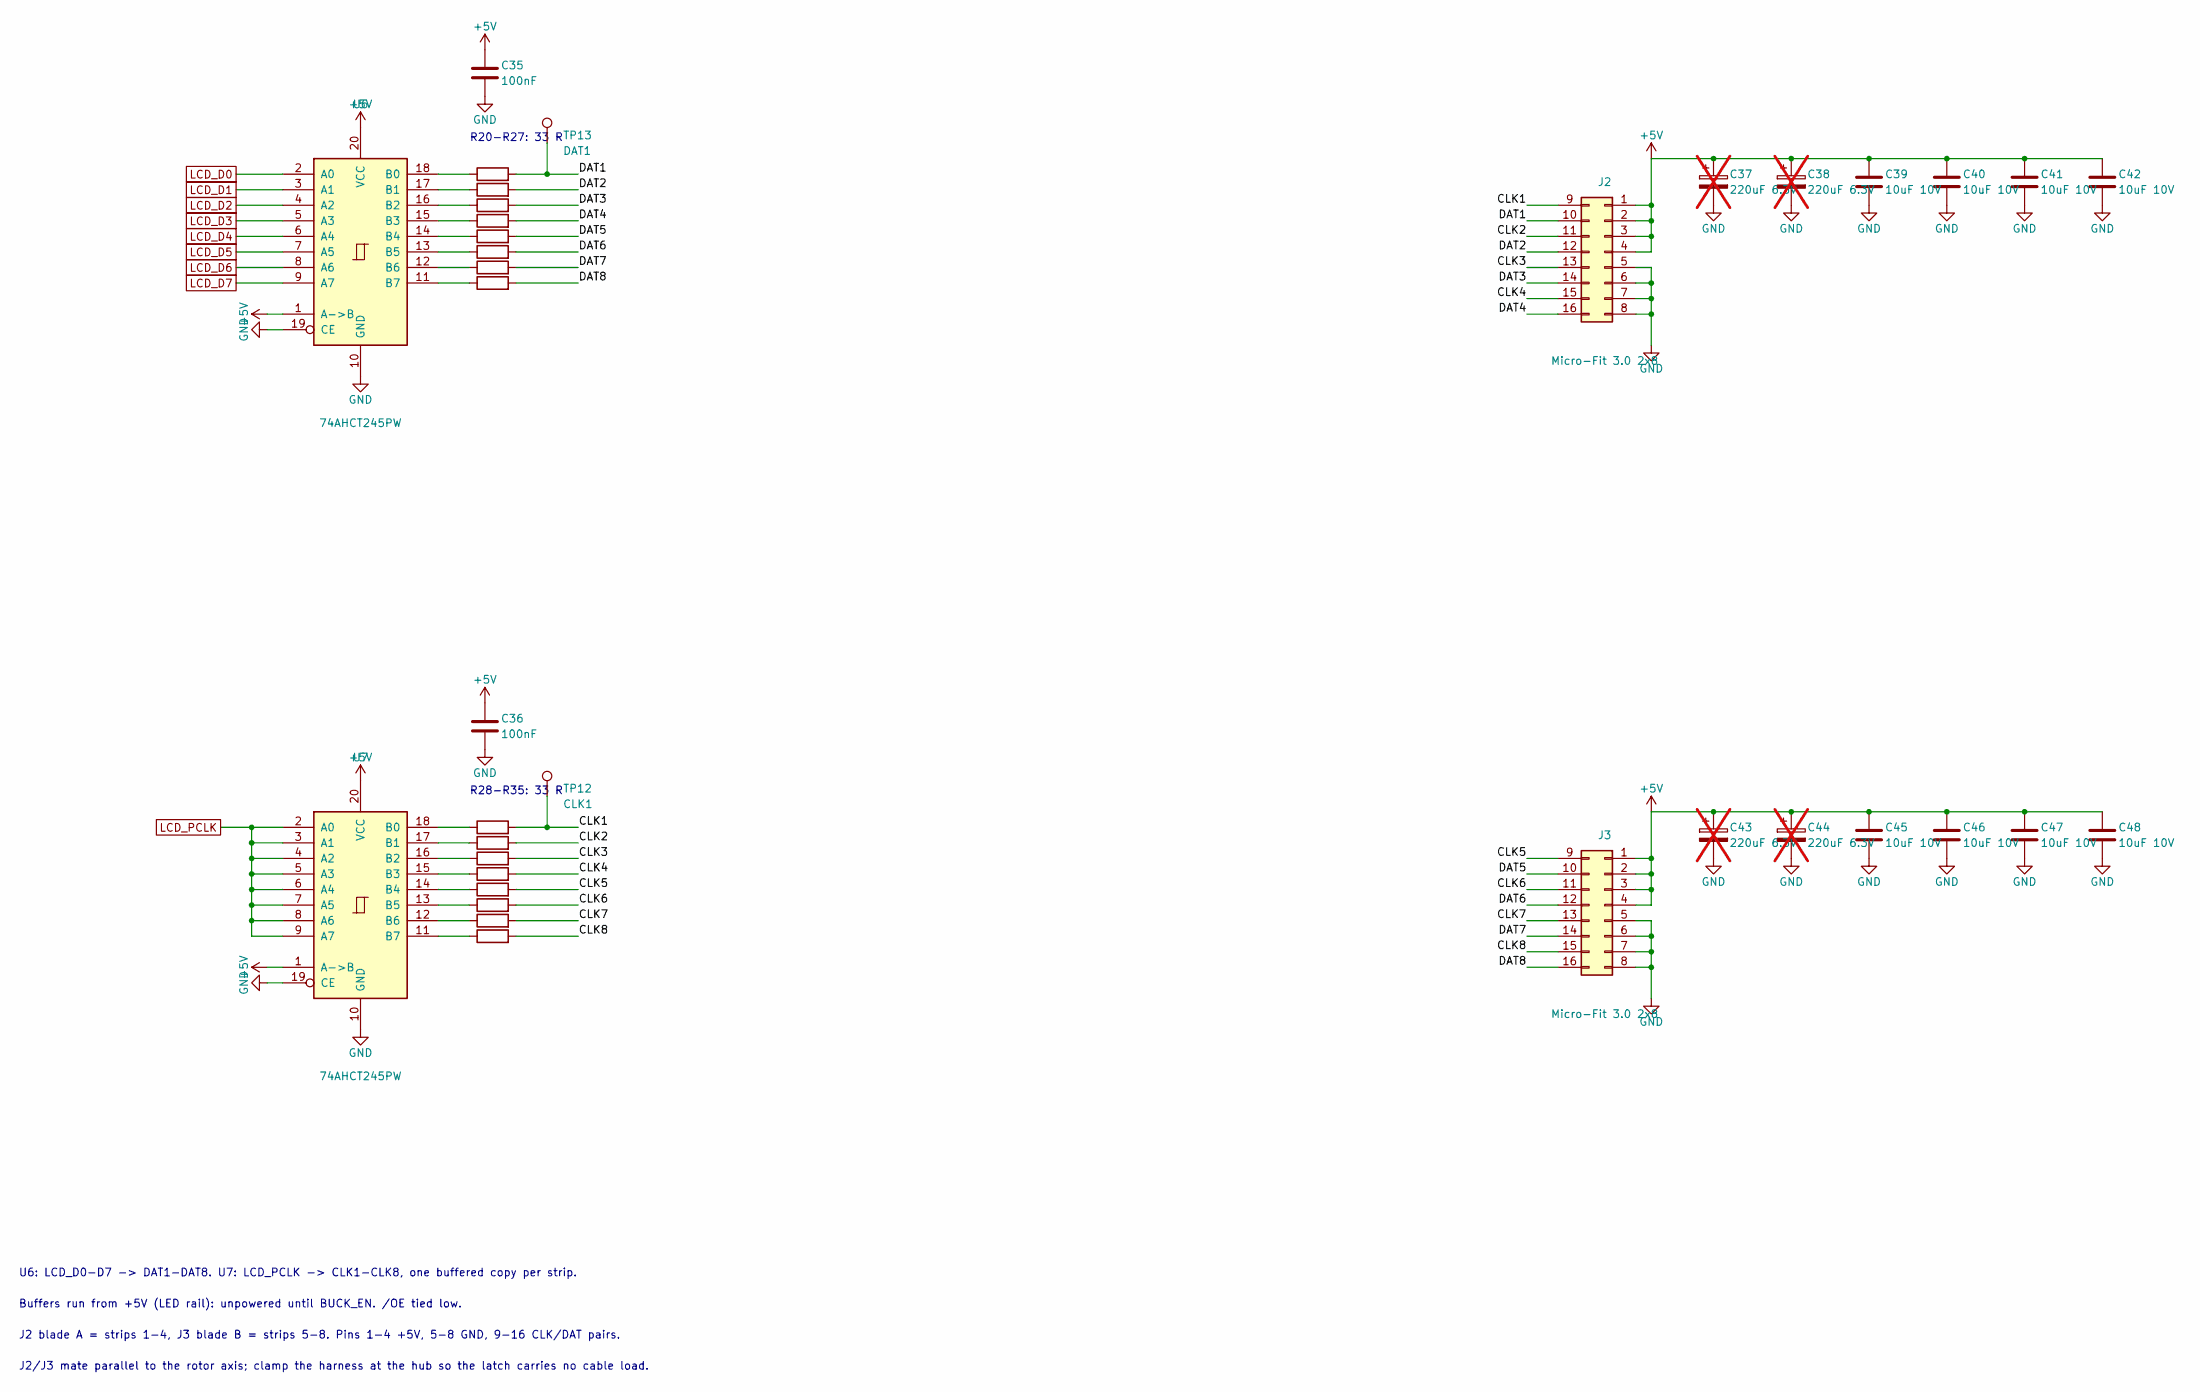
[picture p15: schematic led_out.kicad_sch, povd-hub: LED strip outputs (8 channels, 2 blade connectors)]

Parts:
C35, C36: 100nF; C_0603_1608Metric; LCSC C53084467
C37, C38, C43, C44: 220uF 6.3V; CP_EIA-7343-31_Kemet-D; not fitted
C39, C40, C41, C42, C45, C46, C47, C48: 10uF 10V; C_0805_2012Metric
J2, J3: Micro-Fit 3.0 2x8; Molex_Micro-Fit_3.0_43045-1618_2x08-1MP_P3.00mm_Vertical; MPN Molex 43045-1618 (SMT, vertical, with s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; LCSC C563833
R20, R21, R22, R23, R24, R25, R26, R27, R28, R29, R30, R31, R32, R33, R34, R35: 33; R_0603_1608Metric
TP12: CLK1; TestPoint_Keystone_5015_Micro-Minature; MPN Keystone 5015; LCSC C2906768
TP13: DAT1; TestPoint_Keystone_5015_Micro-Minature; MPN Keystone 5015; LCSC C2906768
U6, U7: 74AHCT245PW; TSSOP-20_4.4x6.5mm_P0.65mm; MPN Nexperia 74AHCT245PW; LCSC C173388

Connections:
+5V: C35.1, C36.1, C37.1, C38.1, C39.1, C40.1, C41.1, C42.1, C43.1, C44.1, C45.1, C46.1, C47.1, C48.1, J2.1, J2.2, J2.3, J2.4, J3.1, J3.2, J3.3, J3.4, U6.1 (A->B), U6.20 (VCC), U7.1 (A->B), U7.20 (VCC); also elsewhere on the board
/led_out/CLK1: J2.9, R28.2, TP12.1 (1_1)
/led_out/CLK2: J2.11, R29.2
/led_out/CLK3: J2.13, R30.2
/led_out/CLK4: J2.15, R31.2
/led_out/CLK5: J3.9, R32.2
/led_out/CLK6: J3.11, R33.2
/led_out/CLK7: J3.13, R34.2
/led_out/CLK8: J3.15, R35.2
/led_out/DAT1: J2.10, R20.2, TP13.1 (1_1)
/led_out/DAT2: J2.12, R21.2
/led_out/DAT3: J2.14, R22.2
/led_out/DAT4: J2.16, R23.2
/led_out/DAT5: J3.10, R24.2
/led_out/DAT6: J3.12, R25.2
/led_out/DAT7: J3.14, R26.2
/led_out/DAT8: J3.16, R27.2
GND: C35.2, C36.2, C37.2, C38.2, C39.2, C40.2, C41.2, C42.2, C43.2, C44.2, C45.2, C46.2, C47.2, C48.2, J2.5, J2.6, J2.7, J2.8, J3.5, J3.6, J3.7, J3.8, U6.10 (GND), U6.19 (CE), U7.10 (GND), U7.19 (CE); also elsewhere on the board
LCD_D0: U6.2 (A0); also elsewhere on the board
LCD_D1: U6.3 (A1); also elsewhere on the board
LCD_D2: U6.4 (A2); also elsewhere on the board
LCD_D3: U6.5 (A3); also elsewhere on the board
LCD_D4: U6.6 (A4); also elsewhere on the board
LCD_D5: U6.7 (A5); also elsewhere on the board
LCD_D6: U6.8 (A6); also elsewhere on the board
LCD_D7: U6.9 (A7); also elsewhere on the board
LCD_PCLK: U7.2 (A0), U7.3 (A1), U7.4 (A2), U7.5 (A3), U7.6 (A4), U7.7 (A5), U7.8 (A6), U7.9 (A7); also elsewhere on the board
unnamed: R20.1, U6.18 (B0)
unnamed: R21.1, U6.17 (B1)
unnamed: R22.1, U6.16 (B2)
unnamed: R23.1, U6.15 (B3)
unnamed: R24.1, U6.14 (B4)
unnamed: R25.1, U6.13 (B5)
unnamed: R26.1, U6.12 (B6)
unnamed: R27.1, U6.11 (B7)
unnamed: R28.1, U7.18 (B0)
unnamed: R29.1, U7.17 (B1)
unnamed: R30.1, U7.16 (B2)
unnamed: R31.1, U7.15 (B3)
unnamed: R32.1, U7.14 (B4)
unnamed: R33.1, U7.13 (B5)
unnamed: R34.1, U7.12 (B6)
unnamed: R35.1, U7.11 (B7)

Notes on the sheet:
R28-R35: 33 R
R20-R27: 33 R
J2 blade A = strips 1-4, J3 blade B = strips 5-8. Pins 1-4 +5V, 5-8 GND, 9-16 CLK/DAT pairs.
U6: LCD_D0-D7 -> DAT1-DAT8. U7: LCD_PCLK -> CLK1-CLK8, one buffered copy per strip.
Buffers run from +5V (LED rail): unpowered until BUCK_EN. /OE tied low.
J2/J3 mate parallel to the rotor axis; clamp the harness at the hub so the latch carries no cable load.

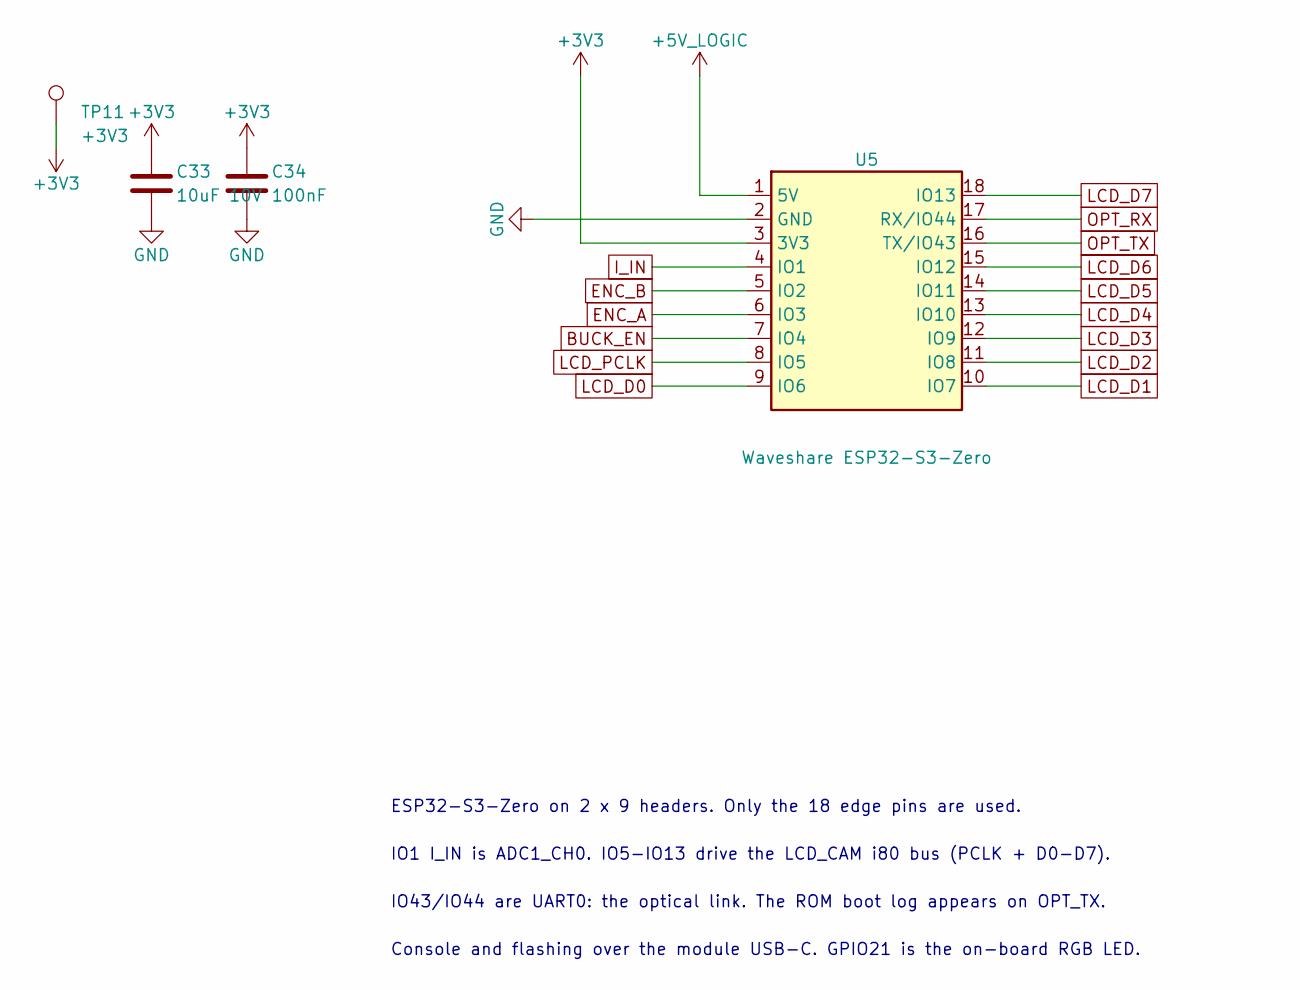
[picture p16: schematic mcu.kicad_sch, povd-hub: ESP32-S3-Zero]

Parts:
C33: 10uF 10V; C_0805_2012Metric
C34: 100nF; C_0603_1608Metric; LCSC C53084467
TP11: +3V3; TestPoint_Keystone_5015_Micro-Minature; MPN Keystone 5015; LCSC C2906768
U5: Waveshare ESP32-S3-Zero; Waveshare_ESP32-S3-Zero_Header; MPN Waveshare ESP32-S3-Zero on 2 x 1x9 2.54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

Connections:
+3V3: C33.1, C34.1, TP11.1 (1_1), U5.3 (3V3); also elsewhere on the board
+5V_LOGIC: U5.1 (5V); also elsewhere on the board
BUCK_EN: U5.7 (IO4); also elsewhere on the board
ENC_A: U5.6 (IO3); also elsewhere on the board
ENC_B: U5.5 (IO2); also elsewhere on the board
GND: C33.2, C34.2, U5.2 (GND); also elsewhere on the board
I_IN: U5.4 (IO1); also elsewhere on the board
LCD_D0: U5.9 (IO6); also elsewhere on the board
LCD_D1: U5.10 (IO7); also elsewhere on the board
LCD_D2: U5.11 (IO8); also elsewhere on the board
LCD_D3: U5.12 (IO9); also elsewhere on the board
LCD_D4: U5.13 (IO10); also elsewhere on the board
LCD_D5: U5.14 (IO11); also elsewhere on the board
LCD_D6: U5.15 (IO12); also elsewhere on the board
LCD_D7: U5.18 (IO13); also elsewhere on the board
LCD_PCLK: U5.8 (IO5); also elsewhere on the board
OPT_RX: U5.17 (RX/IO44); also elsewhere on the board
OPT_TX: U5.16 (TX/IO43); also elsewhere on the board

Notes on the sheet:
ESP32-S3-Zero on 2 x 9 headers. Only the 18 edge pins are used.
IO43/IO44 are UART0: the optical link. The ROM boot log appears on OPT_TX.
Console and flashing over the module USB-C. GPIO21 is the on-board RGB LED.
IO1 I_IN is ADC1_CH0. IO5-IO13 drive the LCD_CAM i80 bus (PCLK + D0-D7).

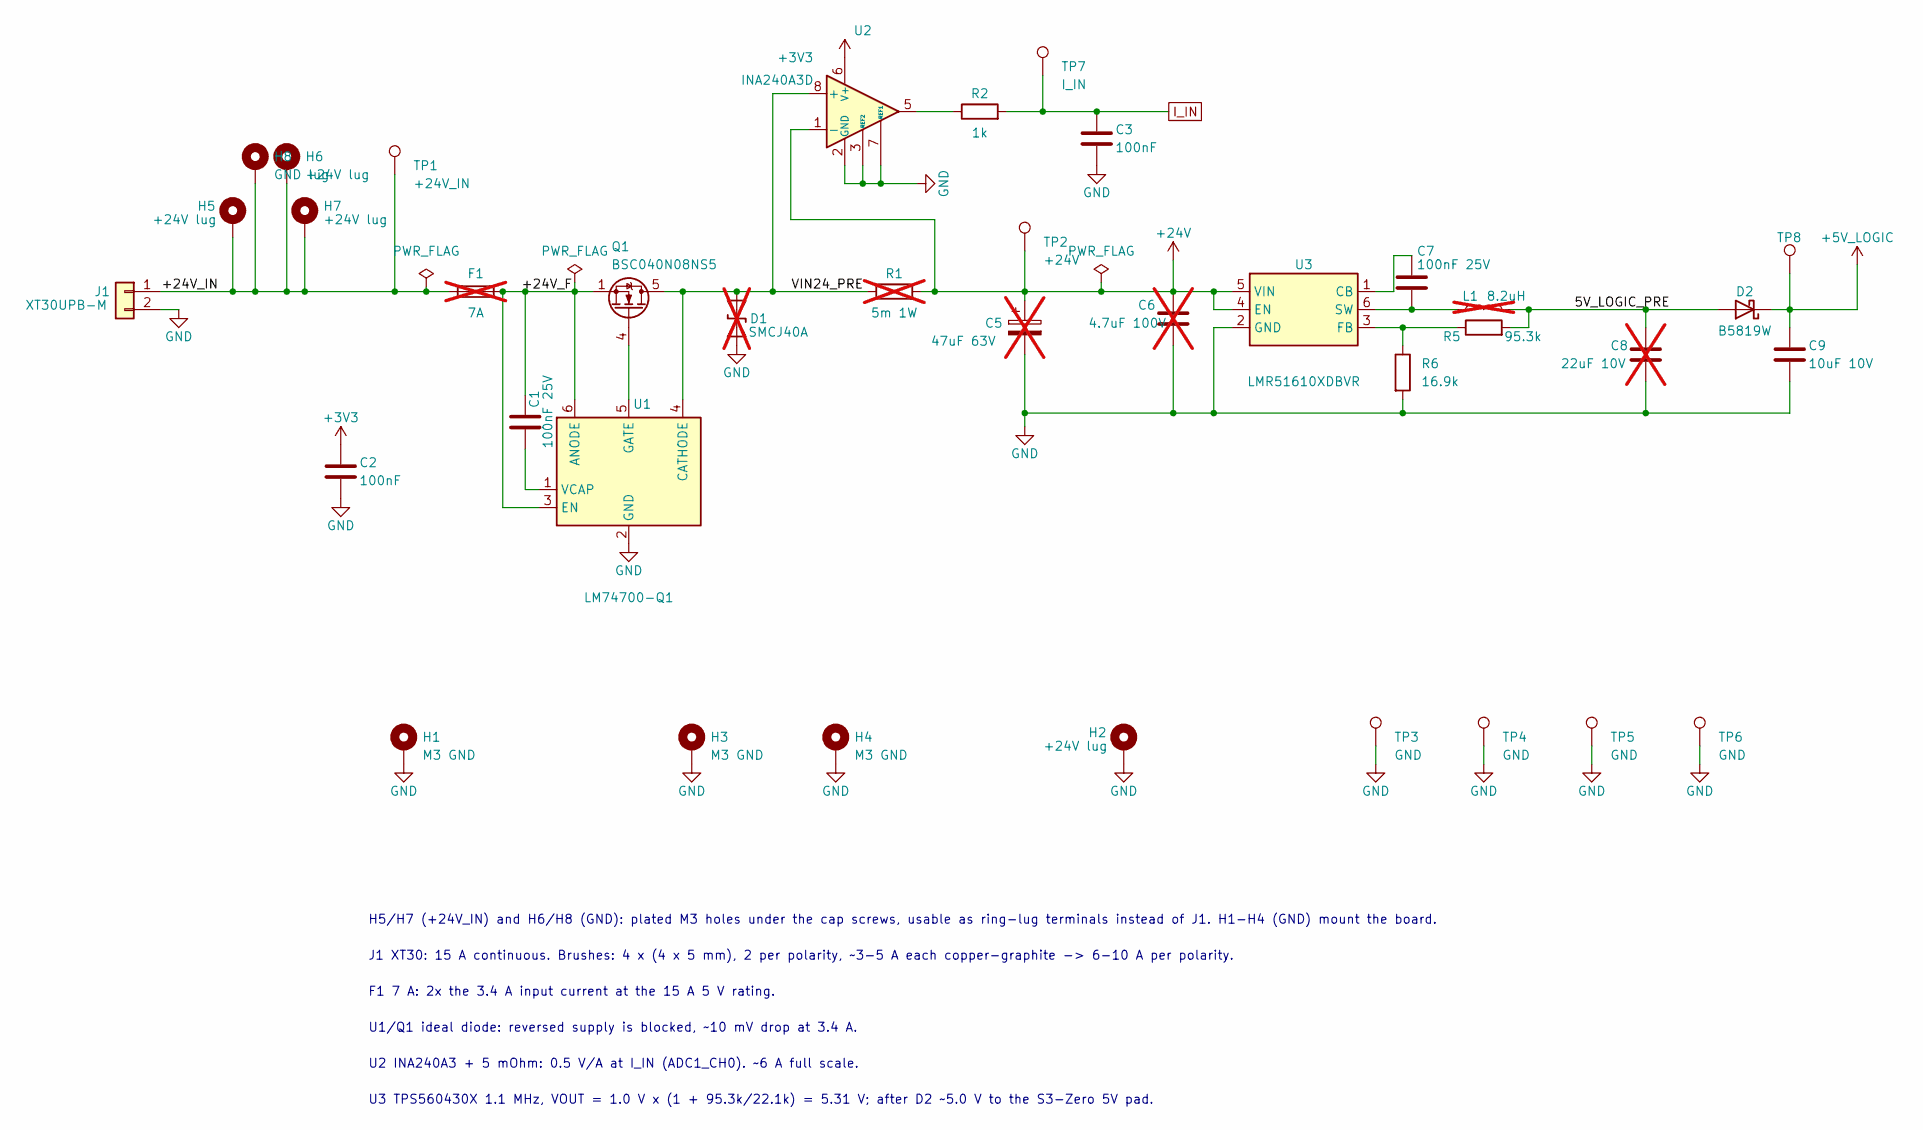
[picture p17: schematic power_in.kicad_sch, povd-hub: 24 V input, protection, current sense, logic supp…]

Parts:
C1, C7: 100nF 25V; C_0603_1608Metric; LCSC C53084467
C2, C3: 100nF; C_0603_1608Metric; LCSC C53084467
C5: 47uF 63V; CP_Elec_8x10; MPN Panasonic EEH-ZA1J470P, 47 uF 63 V hybr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; not fitted
C6: 4.7uF 100V; C_1210_3225Metric; not fitted
C8: 22uF 10V; C_1210_3225Metric; not fitted
C9: 10uF 10V; C_0805_2012Metric
D1: SMCJ40A; D_SMC; MPN Littelfuse SMCJ40A (unidirectional); not fitted
D2: B5819W; D_SOD-123; MPN B5819W (stops USB VBUS back-feed); LCSC C8598
F1: 7A; Fuse_Littelfuse-NANO2-451_453; MPN Littelfuse 0451007.MRL; not fitted
H1, H3, H4: M3 GND; MountingHole_3.2mm_M3_Pad_Via
H2, H5, H6, H7: +24V lug; MountingHole_3.2mm_M3_Pad_Via
H8: GND lug; MountingHole_3.2mm_M3_Pad_Via
J1: XT30UPB-M; AMASS_XT30UPB-M_1x02_P5.0mm_Vertical; MPN Amass XT30UPB-M (15 A cont.), through-h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
L1: 8.2uH; L_Coilcraft_XAL4040-XXX; MPN Coilcraft XAL4040-183 or equiv, Isat >=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; not fitted
Q1: BSC040N08NS5; TDSON-8-1; MPN Infineon BSC040N08NS5 (80 V, 4.0 mOhm, 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; LCSC C534333
R1: 5m 1W; R_2512_6332Metric; MPN 5 mOhm 1 W 2512 current shunt (Kelvin-r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; not fitted
R2: 1k; R_0603_1608Metric
R5: 95.3k; R_0603_1608Metric
R6: 16.9k; R_0603_1608Metric
TP1: +24V_IN; TestPoint_Keystone_5010-5014_Multipurpose; MPN Keystone 5011
TP2: +24V; TestPoint_Keystone_5010-5014_Multipurpose; MPN Keystone 5011
TP3, TP4, TP5, TP6: GND; TestPoint_Keystone_5010-5014_Multipurpose; MPN Keystone 5011
TP7: I_IN; TestPoint_Keystone_5015_Micro-Minature; MPN Keystone 5015; LCSC C2906768
TP8: +5V_LOGIC; TestPoint_Keystone_5015_Micro-Minature; MPN Keystone 5015; LCSC C2906768
U1: LM74700-Q1; SOT-23-6; MPN TI LM74700QDBVRQ1; LCSC C2941042
U2: INA240A3D; SOIC-8_3.9x4.9mm_P1.27mm; MPN TI INA240A3DR (100 V/V); LCSC C2060584
U3: LMR51610XDBVR; SOT-23-6; MPN TI LMR51610XDBVR (4-65 V, 1 A, 400 kHz); LCSC C20539658

Connections:
+3V3: C2.1, U2.6 (V+); also elsewhere on the board
+5V_LOGIC: C9.1, D2.1 (K), TP8.1 (1_1); also elsewhere on the board
+24V: C5.1, C6.1, R1.2, TP2.1 (1_1), U2.1 (-), U3.4 (EN), U3.5 (VIN); also elsewhere on the board
/power_in/5V_LOGIC_PRE: C8.1, D2.2 (A), L1.2, R5.2
/power_in/+24V_F: C1.1, F1.2, Q1.1 (S), Q1.2 (S), Q1.3 (S), U1.3 (EN), U1.6 (ANODE)
/power_in/+24V_IN: F1.1, H5.1 (1_1), H6.1 (1_1), H7.1 (1_1), H8.1 (1_1), J1.1, TP1.1 (1_1)
/power_in/VIN24_PRE: D1.2 (A2), Q1.5 (D), R1.1, U1.4 (CATHODE), U2.8 (+)
GND: C2.2, C3.2, C5.2, C6.2, C8.2, C9.2, D1.1 (A1), H1.1 (1_1), H2.1 (1_1), H3.1 (1_1), H4.1 (1_1), J1.2, R6.2, TP3.1 (1_1), TP4.1 (1_1), TP5.1 (1_1), TP6.1 (1_1), U1.2 (GND), U2.2 (GND), U2.3 (REF2), U2.4 (GND), U2.7 (REF1), U3.2 (GND); also elsewhere on the board
I_IN: C3.1, R2.2, TP7.1 (1_1); also elsewhere on the board
unnamed: Q1.4 (G), U1.5 (GATE)
unnamed: R2.1, U2.5
unnamed: C1.2, U1.1 (VCAP)
unnamed: C7.1, U3.1 (CB)
unnamed: R5.1, R6.1, U3.3 (FB)
unnamed: C7.2, L1.1, U3.6 (SW)

Notes on the sheet:
U2 INA240A3 + 5 mOhm: 0.5 V/A at I_IN (ADC1_CH0). ~6 A full scale.
U1/Q1 ideal diode: reversed supply is blocked, ~10 mV drop at 3.4 A.
H5/H7 (+24V_IN) and H6/H8 (GND): plated M3 holes under the cap screws, usable as ring-lug terminals instead of J1. H1-H4 (GND) mount the board.
J1 XT30: 15 A continuous. Brushes: 4 x (4 x 5 mm), 2 per polarity, ~3-5 A each copper-graphite -> 6-10 A per polarity.
U3 TPS560430X 1.1 MHz, VOUT = 1.0 V x (1 + 95.3k/22.1k) = 5.31 V; after D2 ~5.0 V to the S3-Zero 5V pad.
F1 7 A: 2x the 3.4 A input current at the 15 A 5 V rating.

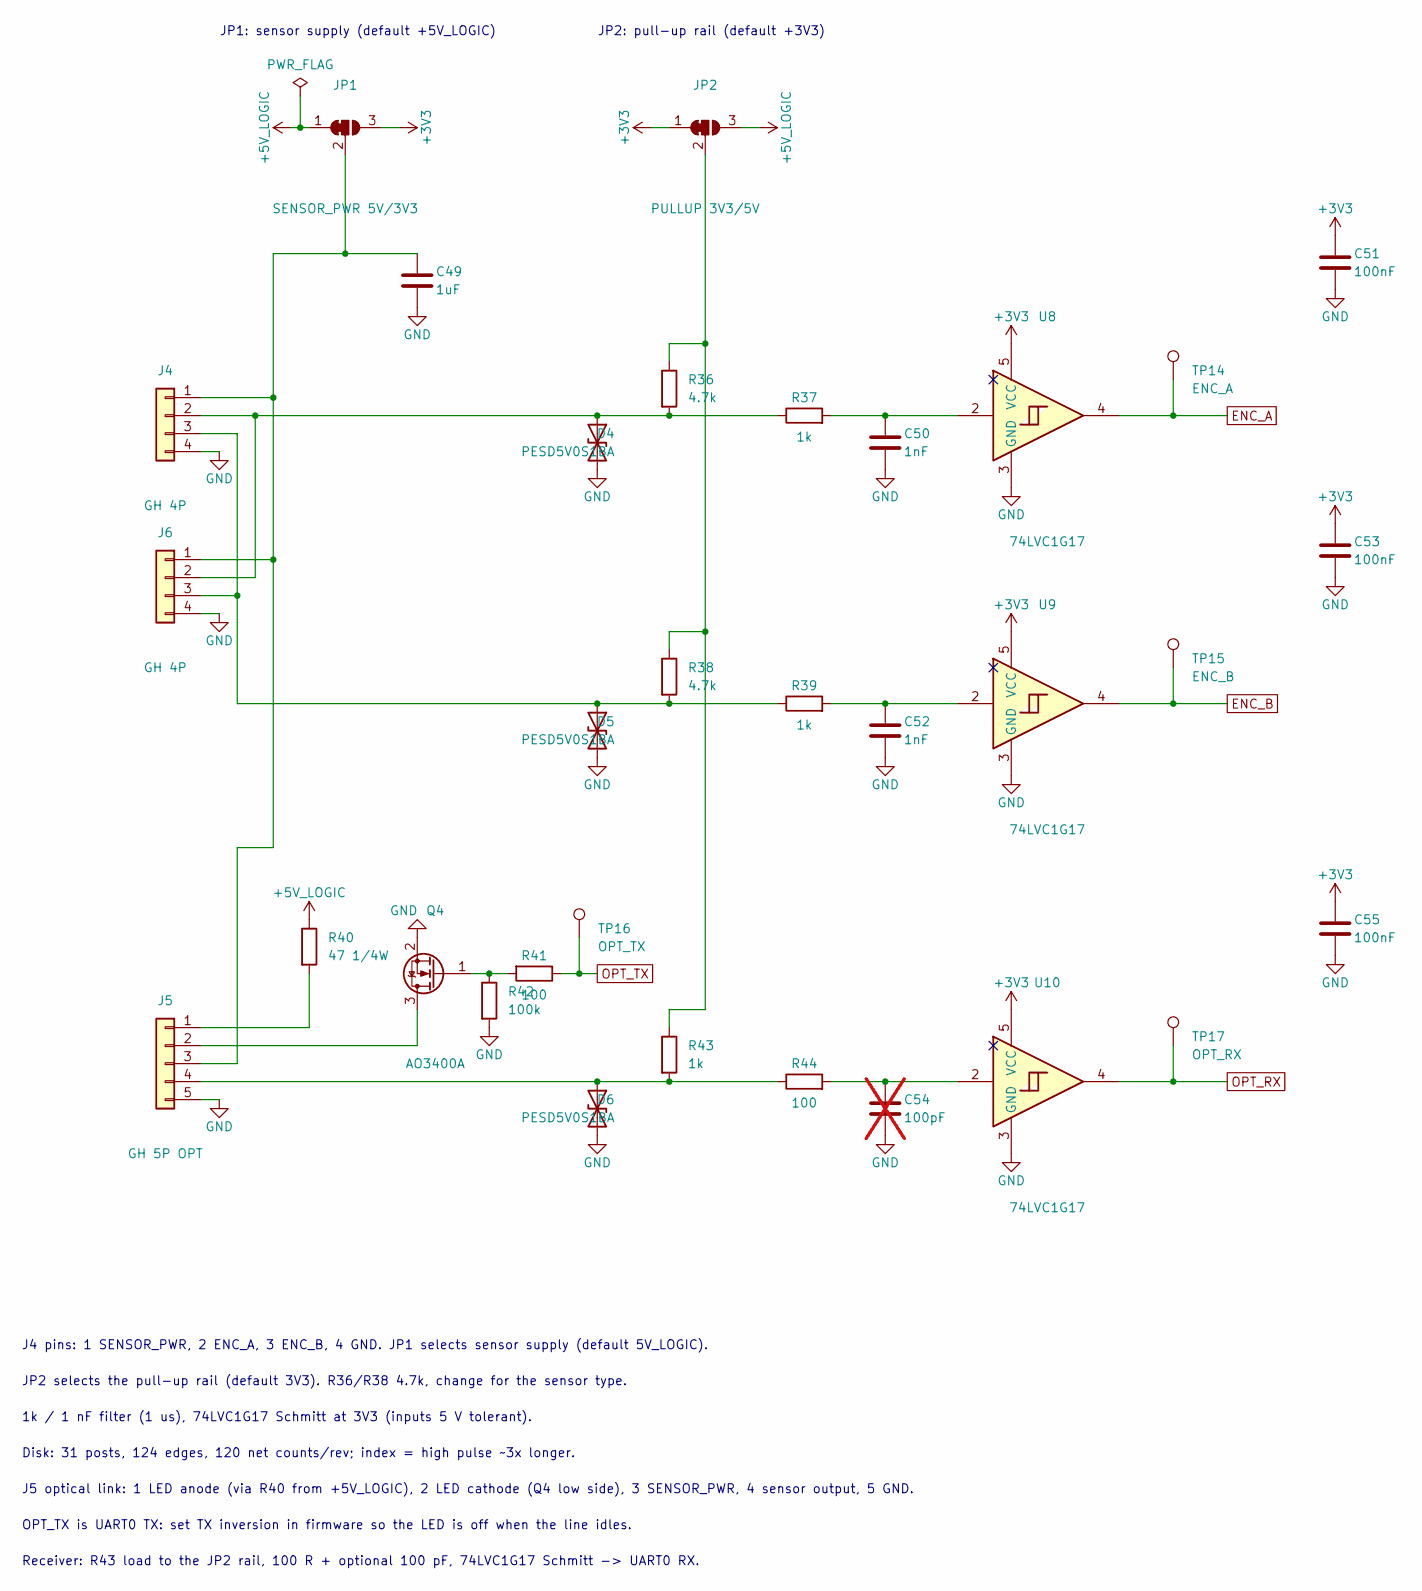
[picture p18: schematic encoder.kicad_sch, povd-hub: Encoder inputs and optical link]

Parts:
C49: 1uF; C_0603_1608Metric
C50, C52: 1nF; C_0603_1608Metric
C51, C53, C55: 100nF; C_0603_1608Metric; LCSC C53084467
C54: 100pF; C_0603_1608Metric; not fitted
D4, D5, D6: PESD5V0S1BA; D_SOD-323; LCSC C19224
J4, J6: GH 4P; JST_GH_BM04B-GHS-TBT_1x04-1MP_P1.25mm_Vertical; MPN JST BM04B-GHS-TBT (vertical, latching); LCSC C161692
J5: GH 5P OPT; JST_GH_BM05B-GHS-TBT_1x05-1MP_P1.25mm_Vertical; MPN JST BM04B-GHS-TBT family, 5 pin (vertic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; LCSC C189891
JP1: SENSOR_PWR 5V/3V3; SolderJumper-3_P1.3mm_Bridged12_RoundedPad1.0x1.5mm
JP2: PULLUP 3V3/5V; SolderJumper-3_P1.3mm_Bridged12_RoundedPad1.0x1.5mm
Q4: AO3400A; SOT-23; MPN AOS AO3400A; LCSC C20917
R36, R38: 4.7k; R_0603_1608Metric
R37, R39: 1k; R_0603_1608Metric
R40: 47 1/4W; R_1206_3216Metric; MPN IR LED current: (5 - 1.4) / 47 = ~75 mA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
R41, R44: 100; R_0603_1608Metric
R42: 100k; R_0603_1608Metric
R43: 1k; R_0603_1608Metric; MPN Sensor load / pull-up. 1k for a phototr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
TP14: ENC_A; TestPoint_Keystone_5015_Micro-Minature; MPN Keystone 5015; LCSC C2906768
TP15: ENC_B; TestPoint_Keystone_5015_Micro-Minature; MPN Keystone 5015; LCSC C2906768
TP16: OPT_TX; TestPoint_Keystone_5015_Micro-Minature; MPN Keystone 5015; LCSC C2906768
TP17: OPT_RX; TestPoint_Keystone_5015_Micro-Minature; MPN Keystone 5015; LCSC C2906768
U8, U9, U10: 74LVC1G17; SOT-23-5; LCSC C7836

Connections:
+3V3: C51.1, C53.1, C55.1, JP1.3 (B), JP2.1 (A), U8.5 (VCC), U9.5 (VCC), U10.5 (VCC); also elsewhere on the board
+5V_LOGIC: JP1.1 (A), JP2.3 (B), R40.1; also elsewhere on the board
ENC_A: TP14.1 (1_1), U8.4; also elsewhere on the board
ENC_B: TP15.1 (1_1), U9.4; also elsewhere on the board
GND: C49.2, C50.2, C51.2, C52.2, C53.2, C54.2, C55.2, D4.2 (A2), D5.2 (A2), D6.2 (A2), J4.4, J5.5, J6.4, Q4.2 (S), R42.2, U8.3 (GND), U9.3 (GND), U10.3 (GND); also elsewhere on the board
unnamed: C50.1, R37.2, U8.2
unnamed: C52.1, R39.2, U9.2
unnamed: C54.1, R44.2, U10.2
unnamed: D4.1 (A1), J4.2, J6.2, R36.2, R37.1
unnamed: D5.1 (A1), J4.3, J6.3, R38.2, R39.1
unnamed: D6.1 (A1), J5.4, R43.2, R44.1
unnamed: C49.1, J4.1, J5.3, J6.1, JP1.2 (C)
unnamed: J5.1, R40.2
unnamed: J5.2, Q4.3 (D)
unnamed: JP2.2 (C), R36.1, R38.1, R43.1
unnamed: Q4.1 (G), R41.2, R42.1
OPT_RX: TP17.1 (1_1), U10.4; also elsewhere on the board
OPT_TX: R41.1, TP16.1 (1_1); also elsewhere on the board

Notes on the sheet:
J4 pins: 1 SENSOR_PWR, 2 ENC_A, 3 ENC_B, 4 GND. JP1 selects sensor supply (default 5V_LOGIC).
1k / 1 nF filter (1 us), 74LVC1G17 Schmitt at 3V3 (inputs 5 V tolerant).
JP2: pull-up rail (default +3V3)
OPT_TX is UART0 TX: set TX inversion in firmware so the LED is off when the line idles.
JP2 selects the pull-up rail (default 3V3). R36/R38 4.7k, change for the sensor type.
Receiver: R43 load to the JP2 rail, 100 R + optional 100 pF, 74LVC1G17 Schmitt -> UART0 RX.
Disk: 31 posts, 124 edges, 120 net counts/rev; index = high pulse ~3x longer.
J5 optical link: 1 LED anode (via R40 from +5V_LOGIC), 2 LED cathode (Q4 low side), 3 SENSOR_PWR, 4 sensor output, 5 GND.
JP1: sensor supply (default +5V_LOGIC)
