lusher00/pov-display/hw/povd-hub/povd-hub.kicad_pcb

## KiCad design hw/povd-hub/povd-hub.kicad_pcb (continued)

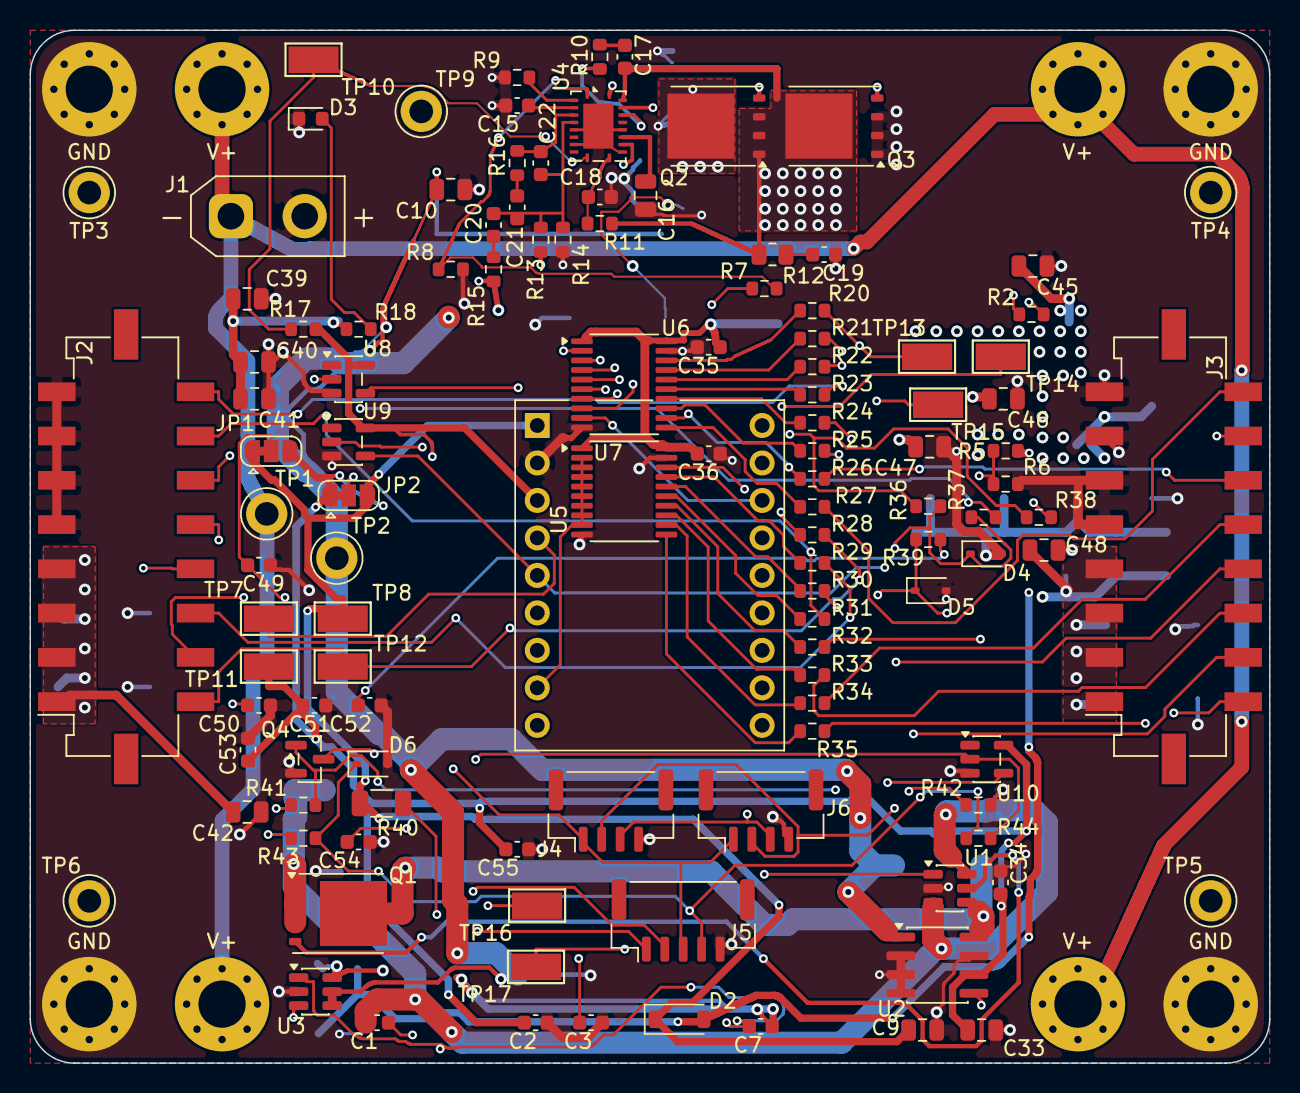
[picture p19: board povd-hub.kicad_pcb from above]

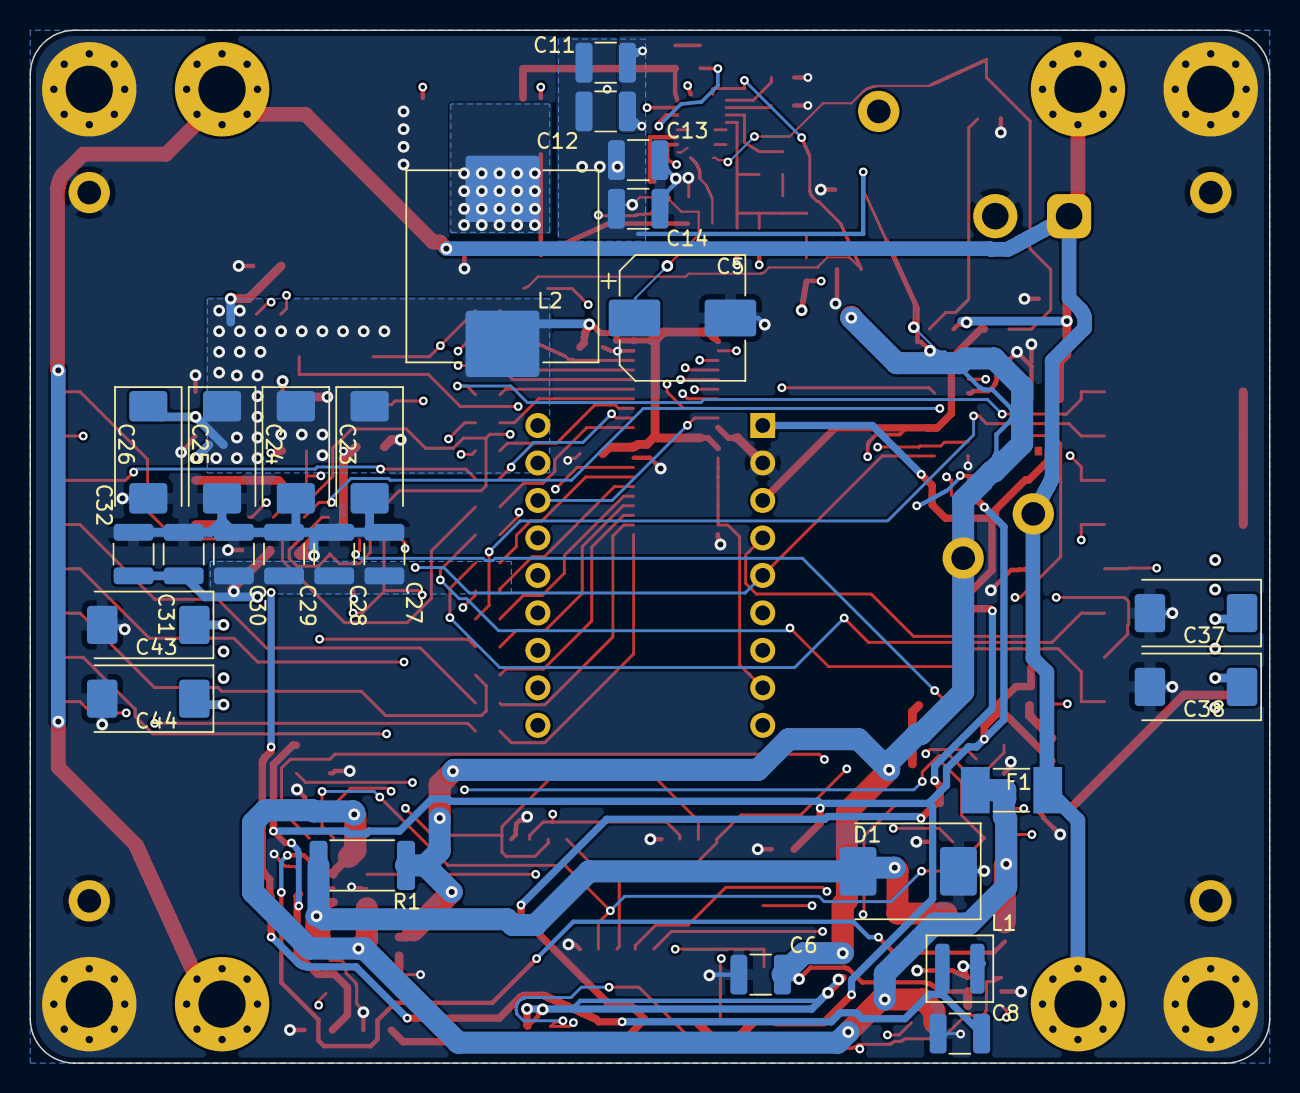
[picture p20: board povd-hub.kicad_pcb from below]

Board: 4 copper layers, 84.0 x 70.0 mm, 151 parts (26 on the bottom side), 90 nets.
