lusher00/pov-display/(commit log)

2026-10-29 pi: hall/MPU/VESC bring-up on rp0-pov-0, bench scripts, rotor speed loop
    - tools/hall_watch.py: A3144 once-per-rev on GPIO4; per-edge print,
    then pulses/s, magnet pitch and rotor rpm once a second. Hand test
    for magnet polarity (south pulls LOW, north ignored).
    - tools/mpu_watch.py: GY-521 (MPU-6050) on I2C1; WHO_AM_I check,
    accel in g, gyro in deg/s. Used to pick imu_axis once bolted down.
    - tools/vesc_test.py: raw VESC UART protocol, no pyvesc. version,
    values, timed duty/rpm/current/brake holds (resent at 20 Hz, end
    with current 0), and which writes battery current max /
    regen, max eRPM, duty and watts with COMM_SET_MCCONF_TEMP. First
    version had the field order wrong and s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
    [buck_5v.kicad_sch, encoder.kicad_sch, led_out.kicad_sch, mcu.kicad_sch, povd-hub.dsn, povd-hub.kicad_pcb, povd-hub.kicad_sch, povd-hub.recovered.2026-10-25_182053.kicad_pcb]
2026-11-03 Add POVD rotor simulator with scripted demo renderers
    tools/sim/povd-sim.html: single-file browser model of the rotor display.
    Config keys for rotor geometry, strips, timing and power, with a readout
    of resolution, refresh, column timing, 5 V and slip-ring current, and
    centrifugal load. Front view paints the persistence image into a pixel
    buffer with the blades drawn over it, each LED lit in its current colour;
    one-blade top view shows the strip layout.
    - persist_ms is the viewer's eye in wall-clock time, so spin_slowdown
    shows LEDs chasing at large values and the image forming as it drops
    - display_hz measured from requestAnimationFrame, overridable
    - sources: grid / text / rings pattern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
2026-11-09 fw: hub firmware (ESP-IDF) with web UI, and Arduino bring-up sketch
    povd_fw (ESP32-S3-Zero, ESP-IDF v5.3 and v6.1):
    - Angle from ENC_A pulses: slots per rev, missing-pulse index (5-1
    pulley pattern), extrapolation between pulses, sim_rpm generator
    - Strip output: LCD_CAM i80 8-bit bus, one SK9822 frame per column on
    all 8 channels by DMA, 8x8 bit transpose from a PSRAM image, output
    task owns core 1, strips blank without sync
    - Patterns: off index chan rings spokes grid wheel solid clock
    - Console on USB: every config key is a command of the same name;
    show, save, defaults, status, buck, i, uart, time, view, wifi
    - WiFi station + mDNS (http://povd.local, reserved 192.168.1.116);
    we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
    [angle.c, board.c, bringup.ino, config.c, console.c, leds.c, main.c, povd.h]
